SirDomsen/RC-LAP-TIMER-PRO/ROADMAP.md

# 🏁 RC LAP TIMER PRO – SYSTEM ROADMAP & ARCHITEKTUR

> **Interne System-Roadmap & Modulübersicht für AI-Assistenten und Entwickler.**  
> *Stand Firmware: v4.7.0 | Basisstation: ESP8266 oder ESP32-S3 + Sektorstationen: ESP-01S + Transponder: ATtiny13A*

---

## 🧭 1. Projektübersicht & Philosophie
**RC Lap Timer Pro** ist ein autarkes, hochpräzises Infrarot-Rundenzählersystem für RC-Cars (Maßstäbe 1:10, 1:8, 1:24 etc.). Die Basisstation läuft auf ESP8266 oder ESP32-S3; Bedienung und Live-Anzeige erfolgen über ein responsives Web-Frontend (HTML5 / Vanilla JS / WebSockets).

* **Basisstation (`LT_Base/`):** Gemeinsame Rennlogik und Web-App mit separaten ESP8266- und ESP32-S3-Hardwareadaptern; empfängt Start/Ziel-Transponder, betreibt Webserver/WebSockets und verwaltet Rekorde und Sessions.
* **Sektorstationen (`LT_SectorStation/`, SZ1–SZ3):** Eigenständiges ESP-01S-Projekt. Die Stationen erfassen Zwischenzeiten und übertragen sie synchronisiert per ESP-NOW an die Basis.
* **Transponder (`attiny13_tx/`):** ATtiny13-Sender in jedem RC-Car mit individuellen 12-Bit-IR-Codes auf 38 kHz.

---

## ⚙️ 2. PlatformIO Environments & Build-Konfiguration

Die Projekte besitzen getrennte PlatformIO-Konfigurationen. `LTCommon` liegt unter `LT_Base/lib/LTCommon/` und wird sowohl von der Basis als auch von den Sektorstationen eingebunden.

| Projekt / Environment | Board | Takt | Dateisystem | Zweck |
| :--- | :--- | :--- | :--- | :--- |
| `LT_Base` / `basisstation` | NodeMCU V2 (`nodemcuv2`) | 160 MHz | LittleFS | ESP8266-Basis, LWIP2 Low Memory |
| `LT_Base` / `basisstation_s3` | ESP32-S3 DevKitC-1 N16R8 | 240 MHz | LittleFS | ESP32-S3-Basis, 16 MB Flash, 8 MB Octal-PSRAM, USB-CDC |
| `LT_SectorStation` / `sz1` | ESP-01S (`esp01_1m`) | 160 MHz | - | Sektorstation 1 (`-DSECTOR_STATION -DSTATION_ID=1`) |
| `LT_SectorStation` / `sz2` | ESP-01S (`esp01_1m`) | 160 MHz | - | Sektorstation 2 (`-DSECTOR_STATION -DSTATION_ID=2`) |
| `LT_SectorStation` / `sz3` | ESP-01S (`esp01_1m`) | 160 MHz | - | Sektorstation 3 (`-DSECTOR_STATION -DSTATION_ID=3`) |

Builds werden vom Repository-Root aus z. B. mit `pio run -d LT_Base -e basisstation`, `pio run -d LT_Base -e basisstation_s3` oder `pio run -d LT_SectorStation -e sz1` gestartet. Das LittleFS-Image der Basis wird mit `pio run -d LT_Base -e basisstation -t buildfs` gebaut.

---

## 📡 3. Hardware- & Signal-Architektur

### 3.1 Transponder (`attiny13_tx/Attiny_tx.ino`)
* **Hardware:** ATtiny13A (9.6 MHz intern), IR-LED an PB3.
* **Signal:** 38 kHz Burst (Impulsbreiten-Codierung).
* **Frame-Struktur:** 12-Bit Micro-Frame (~16 ms Dauer).
  * Leader: 2000 µs Puls + 1000 µs Pause.
  * Daten: 6 Bit Car-ID (1–15, ID 0 = Startschranke) + 6 Bit invertierte Car-ID zur Fehlerprüfung.
  * Bit 0 = 350 µs Puls / 350 µs Pause (~700 µs).
  * Bit 1 = 350 µs Puls / 1050 µs Pause (~1400 µs).
* **Entzerrung:** LFSR Pseudo-Zufallspause von 15 bis 30 ms zwischen Sendungen (verhindert Signalüberlagerung bei Pulkfahrten).

### 3.2 IR-Decoder (`LT_Base/lib/LTCommon/src/ir_decoder.cpp`)
* **Hardware:** TSOP4838 an D2 (GPIO4 bei Basis) bzw. GPIO3/RX (ESP-01S bei SZ).
* **Empfang:** Interrupt auf fallende Flanke (`handleIRInterrupt()`).
* **Sicherheit:** Striktes Timing-Fenster für Header (1800–4200 µs) und Bits (400–1800 µs, Schwelle 950 µs). Bei jeder kleinsten Abweichung erfolgt ein sofortiger Hard-Reset des Schieberegisters.

### 3.3 ESP-NOW Funknetzwerk (`esp_now_base.cpp` & `LT_SectorStation/src/main.cpp`)
* **Sync-Master:** Basis sendet periodische Beacons (`BeaconSyncPacket`, Stratum 0).
* **Kanal-Verfolgung:** Sektorstationen hoppen durch die WLAN-Kanäle bis zum Beacon-Lock.
* **Multi-Hop / Stratum:** Stationen synchronisieren lokale Mikrosekunden mit ~1 ms Hop-Kompensation und leiten Pakete weiter (Relay Queue & Cache).
* **Heartbeat & Telemetrie:** Alive-Pakete melden Status und Batteriespannung (Teiler an A0).
* **Remote OTA-Trigger:** Basis kann SZs über ESP-NOW anweisen, in den Wartungsmodus zu wechseln und sich mit dem Heim-WLAN oder AP für Firmware-Updates zu verbinden.

---

## 💻 4. Backend-Architektur Basisstation (`LT_Base/src/common/`)

### 4.1 Zeit- & Rennlogik (`lap_logic.cpp`)
* **Rennmodi:**
  * `MODE_PRACTICE` (0): Freies Training, endlose Zeiterfassung, automatische Erkennung.
  * `MODE_QUALIFYING` (1): Zeitbasiertes Qualifying mit automatischer Restzeitansage.
  * `MODE_RACE_LAPS` (2): Rennen auf Rundenanzahl (Startampel / Countdown, Zieldurchfahrt).
  * `MODE_RACE_TIME` (3): Rennen auf Zeit (z. B. 5-Minuten-Lauf, letzte Runde zu Ende fahren).
  * `MODE_DRAGRACE` (4): Sprint-Messung (Start an Basis, Sektor-Messung bis Zielschranke).
* **Sektoren (SZ1–SZ4):** S1 bis S3 von Funk-Stationen, S4 = Zieldurchfahrt Basis. Berechnung von Einzel- und Splitzeiten, Personal Best (PB, Grün) und absoluter Bestzeit (Purple).
* **Filterung & Entprellung:**
  * 2-Frame-Filter (erfordert zwei identische Frames innerhalb von 85 ms).
  * Einstellbare Deadtime (`minLapTimeMs`, Standard 2000 ms).
  * Dynamische Boxen-/Pause-/Outlap-Erkennung bei langen Standzeiten.

### 4.2 Speicherverwaltung (`storage.cpp`)
* **Dateisystem LittleFS:**
  * `/tracks.json`: Streckenkatalog mit All-Time Top 5 und Tagesbestzeiten Top 5.
  * `/sessions.json`: Index aller gefahrenen Sessions.
  * `/<track>/<mode>/<YY-MM-DD_HH-MM-SS>.json`: Detaillierte Rundenprotokolle inklusive aller 4 Sektoren und Zeitstempel.
  * `/wifi.json` & `/names.json`: WLAN-Zugänge, Fahrer- und Fahrzeugnamen (bis zu 15 Fahrzeuge).
* **Pufferung & Schutz:**
  * `PendingLap lapQueue[30]`: Rundenzeiten werden im RAM gepuffert und asynchron weggeschrieben, um den Loop nicht zu blockieren.
  * **95%-Flash-Schutz (`storageFullLocked`):** Verhindert das Einfrieren des ESP8266 bei vollem Speicher.
  * Reset-Ursache und Details werden in einem größenbegrenzten `/crash.log` protokolliert; der Webserver stellt Crash-Log und Dateisystembelegung über leichtgewichtige Diagnose-Endpunkte bereit.

### 4.3 Arcade-Sound & Signal-Akustik (`buzzer.cpp` / `buzzer.h` / `Sound/`)
* **Hardware:** 32Ω Mylar- oder PC-Lautsprecher an **D1 (GPIO5)**, getrieben über **BC337-Transistor** (1kΩ Basiswiderstand) an 5V/VIN.
* **Architektur:** 100% non-blocking State-Machine im `loop()`, **0 Byte Heap-Allokation** (alle Tonfolgen in `PROGMEM` unter `LT_Base/Sound/`), dynamische Staccato-Artikulation für klassische MIDI- und `wav2c`-extrahierte Notenfolgen.
* **Sound-Events & Soundtracks:**
  * **Startampel:** Original Grand Prix Circuit (1988) Sequenz (2x Rot 260 Hz à 300 ms, 650 ms Pause ➔ Grün 1050 Hz à 450 ms), synchronisiert mit Renn-Countdown in `modes.js`.
  * **Zieldurchfahrt:** Kurzer, trockener Bestätigungs-Impuls (1760 Hz, 35 ms) direkt bei Zieldurchfahrt in `lap_logic.cpp`.
  * **Streckenrekord:** Aufsteigende 4-Ton Arcade-Fanfare bei neuem Streckenrekord / absoluter Bestzeit.
  * **Sieg über Geist / Geisterjagd:** Schnelle 6-Ton Sieges-Fanfare (G4-C5-E5-G5-E5-G5) bei Unterbietung der Geisterzeit.
  * **SZ-Durchfahrts-Ticks:** A7 Chiptune-Tick (3520 Hz) an Zwischenstationen SZ1–SZ3 als akustisches Lebenszeichen / Latenz-Rückmeldung (Fahrer 1 Einzeltick 25 ms, Fahrer 2 Doppeltick).
  * **Accolade Arcade Jukebox (8 Original MS-DOS Chiptunes):**
    * *Grand Prix Circuit (1988):* 🏎️ Title Theme (180 Noten, 32s) & 🏁 Menu Theme (448 Noten, 54s).
    * *Test Drive 1 (1987):* 🚗 Intro / Title Theme & ⚡ Menu Beat (authentischer Synth-Groove).
    * *Test Drive 3: The Passion (1990):* 🔥 Title Theme, 📻 Radio 1 (Synth-Rock), 📻 Radio 2 (Synth-Bass), 📻 Radio 3 (Melodic Groove).
* **Steuerung & UI-Integration:**
  * **Rennleiter Jukebox-Modal (`admin.html`):** Button `📼 Arcade Audio` öffnet dedizierten Player mit Soundtrack-Dropdown, Loop-Schalter, Play/Stop und Sound FX Tests.
  * **Countdown-Stummschaltung:** Einstellbar im Fahrer-Setup (`index.html`) und direkt im Arcade-Modal des Rennleiters (`admin.html`) für 100% synchronen Startampel-Buzzer ohne Sprach-Latenz.
  * **Web-API:** `/api/buzzer` (`cmd=play&track=<id>&loop=1|0`, `cmd=start|lap|record|title|menu|stop`, `enable=1|0`).
* **Ruhestrom-Schutz:** Pin wird im Standby fest auf `LOW` gehalten, sodass der Transistor komplett sperrt und kein Strom fließt.

### 4.4 Webserver & Netzwerk (`web_server.cpp` / `web_handlers.cpp`)
* **WLAN-Kaskade:** Heim-WLAN ➔ Mobiler Hotspot ➔ Eigener SoftAP (`RC-LapTimer-XXXX`, höchstens 4 WLAN-Clients; im AP-Modus höchstens 3 aktive Fahrer-WebSockets).
* **Gelernte IP:** Merkt sich die im Heimnetz vergebene IP und nutzt diese auch im SoftAP, damit Browser-Lesezeichen immer gültig bleiben.
* **Geister-WLAN (`setupGhostWLAN()`):** Nach dem Booten im Heimnetz wird kurzzeitig ein eigenes Hilfs-WLAN mit der IP im Namen aufgespannt (`LT_<SSID>-<IP>`), damit der Nutzer die IP sofort sieht. Schaltet nach dem ersten Webaufruf automatisch ab.
* **Dynamischer Heap-Schutz:** Der Datei-Guard passt seine ESP8266-Grenzen dem WLAN-Modus an (AP: 5.5 kB / 75 % Fragmentierung / 1.4 kB größter Block; Station: 7.5 kB / 70 % / 1.8 kB). `/api/laps` hat einen separaten 3.5-kB-Guard (ESP8266; 8 kB auf S3); WebSocket-Neuverbindungen werden bei knappem Heap oder belegten Fahrer-Slots mit Code 1013 abgewiesen. CSS/JS bleiben für den Recovery-Loader abrufbar.
* **4-Säulen Client-Lifecycle:** Verhindert TCP-PCB-Erschöpfung auf dem ESP8266 im AP-Modus:
  1. `tabId`-Zuordnung via `sessionStorage` (Reloads im selben Browser-Tab ersetzen alte Sockets gezielt).
  2. TCP-Sendestau-Erkennung (`queueLen() > 0` für $\ge 8\,\text{s}$) für gesperrte Handys im Standby.
  3. Der WebSocket-Gate lässt im AP-Modus maximal drei Fahrer zu und weist weitere Verbindungen zurück, statt bestehende Fahrer zu verdrängen. `ws.cleanupClients()` entfernt nur geschlossene Clients.
  4. Sauberes Teardown via `pagehide` / `beforeunload` ohne Reconnect-Stürme.
* **Grand Prix Circuit Startampel & Standby-Re-Sync:**
  * Visuelle Ampel-Heartbeat-Anzeige (Rot=Standby, Gelb=Sync, Grün=Live) auf Fahrer- und Admin-Seite sowie im OLED-Dimmer.
  * Automatischer Reconnect mit 500 ms WLAN-Stabilisierungspuffer beim Entsperren des Smartphones ohne manuelles Neuladen.

---

## 🖥️ 5. Frontend-Architektur (`LT_Base/data/`)

* **`index.html` (Fahrer-Dashboard):**
  * Bereinigtes Display für Teilnehmer und Zuschauer.
  * Integrierter **OLED-Dimmer-Modus**: Großschrift-Ansicht für Handys an der Strecke mit minimalem Akkuverbrauch.
* **`admin.html` (Rennleiter):**
  * Vollzugriff auf Session-Steuerung, Streckenwechsel, Fahrerumbenennung, Sensor-Live-Debug und Hardware-Konfiguration.
* **`main.js`:**
  * Zentraler Controller, WebSocket-Event-Verarbeitung (`lap`, `sector`, `outlap`, `drag_start`, `drag_finish`).
  * Live-Leaderboard-Rendering mit Delta-Zeiten zur Bestzeit.
* **`modes.js`:**
  * Start-Sequenzen (3-2-1-Los Sprachcountdown), Rennabbruch, Runden- und Zeit-Sessions.
* **`stats.js`:**
  * Multi-Tab-Statistiken (Fahrerprofile, Trainings, Quali, Rennen, Dragrace).
  * Strecken-Filterung, Session-Details mit Einzelrunden.
  * **Backup & Restore:** Vollständiger JSON-Export und Wiederherstellung aller Strecken- und Session-Daten.
* **`config.js`:**
  * Dialoge für WLAN-Umschaltung, Transponder-Deadtime, 2-Frame-Filter, Sektor-Audio, Cache-Steuerung und SZ-OTA.
* **`tts.js`:**
  * Web Speech API Sprachausgabe auf Deutsch (`de-DE`).
  * Sprach-Warteschlange mit Watchdog, gezielte Fahrer-Filterung ("Nur mein Auto ansagen"), iOS-Audio-Unlock.
* **`update.html`:**
  * LittleFS-Dateimanager (Ordner-Ansicht, ZIP-Download einzelner Ordner oder des gesamten Speichers) und Firmware-OTA-Upload.
* **`debug.html`:**
  * Live-Monitoring von ESP-Loop-Zeiten, Heap, ESP-NOW Funkpaketen und Signalstärken via Dual-Endpunkt (`/api/debug/system` & `/api/system/metrics`) mit dynamischer Farbkodierung (Neon-Cyan / Grün / Orange / Rot).
  * Integrierte **Frontend- & Asset-Live-Diagnose** (automatische Prüfung von HTTP-Status, GZIP-Kompression, JS-Syntax und WebSocket-Handshake für alle 4 Webseiten inklusive `update.html` und `debug.html`).
  * Integrierte **Audio & Buzzer Test-Konsole**: 3-teilige Prüfumgebung mit interaktiven Buttons für ESP8266 Hardware-Buzzer FX & 8-Track Jukebox, Smartphone Web Audio Synthesizer (100% klanggleich) und Web Speech API (TTS-Rennansagen).
* **`banner.jpg` / `banner.webp` & `style.css`:**
  * Original Synthwave/Arcade Hero-Banner (1024×434 px, 2,36:1 Breitwandformat) mit Zielflaggen-Muster und integriertem "RC LAP TIMER" Logo im `.hero-header`.
  * Perfekt proportionierte, unverzerrte Skalierung (`aspect-ratio: 1024 / 434`) ohne HTML-Textüberlagerung.
  * Schmale, zentrierte Rollen-Umschaltleiste (`.role-badge-bar`) direkt unter dem Banner vor den Funktions-Cards.

---

## 🗺️ 6. Funktions- & Modul-Matrix

```mermaid
flowchart TD
    subgraph Hardware
        TX[ATtiny13 TX Transponder 38kHz] -->|IR Signal| TSOP[TSOP4838 Sensor]
        SZ[ESP-01S Sektorstationen SZ1-SZ3] -->|ESP-NOW Funksignal| BASE[Gemeinsame Basisstations-Firmware]
        TSOP --> BASE
    end

    subgraph Firmware_Backend
        BASE --> TARGET[ESP8266- oder ESP32-S3-Adapter]
        BASE --> IR_DEC[IR Decoder ISR]
        BASE --> ESPNOW_RX[ESP-NOW Base Receiver]
        IR_DEC --> LAP_CORE[Lap Logic & Sektorberechnung]
        ESPNOW_RX --> LAP_CORE
        LAP_CORE --> STORAGE[Storage Manager LittleFS & EEPROM]
        LAP_CORE --> WS_SRV[Async WebServer & WebSockets]
    end

    subgraph Web_Frontend
        WS_SRV -->|WebSocket Live Events| CLIENT_WS[websocket.js]
        CLIENT_WS --> UI_MAIN[main.js / Live Table]
        CLIENT_WS --> UI_TTS[tts.js / Sprachausgabe]
        UI_MAIN --> UI_MODES[modes.js / Rennabläufe]
        STORAGE -->|REST API / JSON| UI_STATS[stats.js / Runden & Rekorde]
        STORAGE -->|REST API / JSON| UI_CFG[config.js / Einstellungen]
    end
```

---

## 📋 7. Unverzichtbare Entwicklungsregeln für Antigravity

1. **Zuerst reden, dann coden:** Jede Codeänderung oder Feature-Erweiterung wird zuerst diskutiert und konzipiert. Erst nach Bestätigung des Users wird editiert.
2. **Projektstruktur:** Basisstationsquellen und Webassets gehören nach `LT_Base/`; Sektorstationsquellen nach `LT_SectorStation/`; die Transponder-Referenz bleibt unter `attiny13_tx/`. Gemeinsame Decoder- und Protokollteile liegen in `LT_Base/lib/LTCommon/`.
3. **Cache-Busting-Pflicht:** Sobald `LT_Base/data/*.js` oder `LT_Base/data/*.css` geändert werden, **muss** die Versionsnummer in `admin.html`, `index.html` und `LT_Base/src/common/config.h` (`FIRMWARE_VERSION`) synchron erhöht werden (`?v=X.X.X`).
4. **RAM-Schonung auf dem ESP8266:** Nie blockierende Loops oder große Strings auf dem Heap erzeugen. JSON-Dokumente strikt mit ArduinoJson 7 reservieren oder direkt streamen.
5. **Code-Integrität:** Bestehende Sicherheitsmechanismen (Heap-Guard, 95%-Flash-Schutz, Sektor-Entprellung, ISR-Zeitschranken) niemals aus Versehen entfernen oder abschwächen; Änderungen am gemeinsamen Basisstationskern müssen für ESP8266 und ESP32-S3 gebaut werden.
