SirDomsen/RC-LAP-TIMER-PRO/SChaltplanASCII.docx

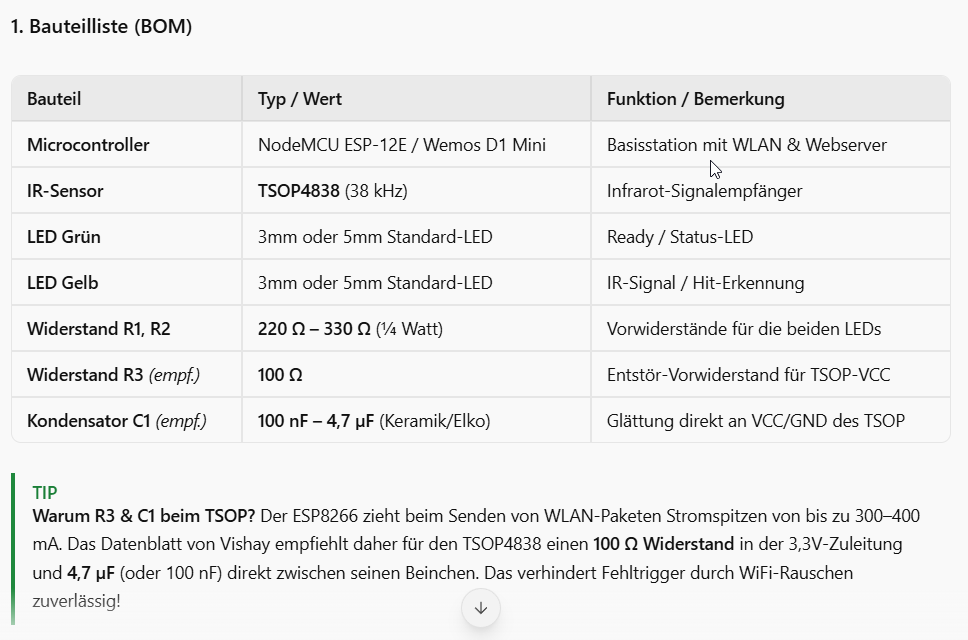
[picture p1: figure]
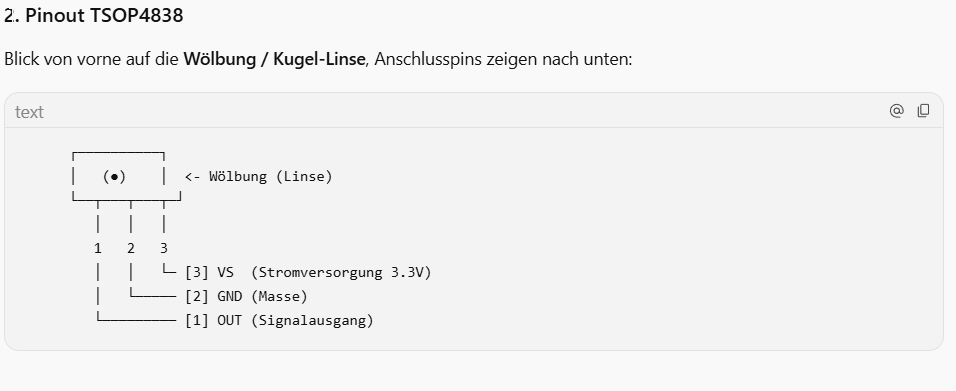
[picture p2: figure]
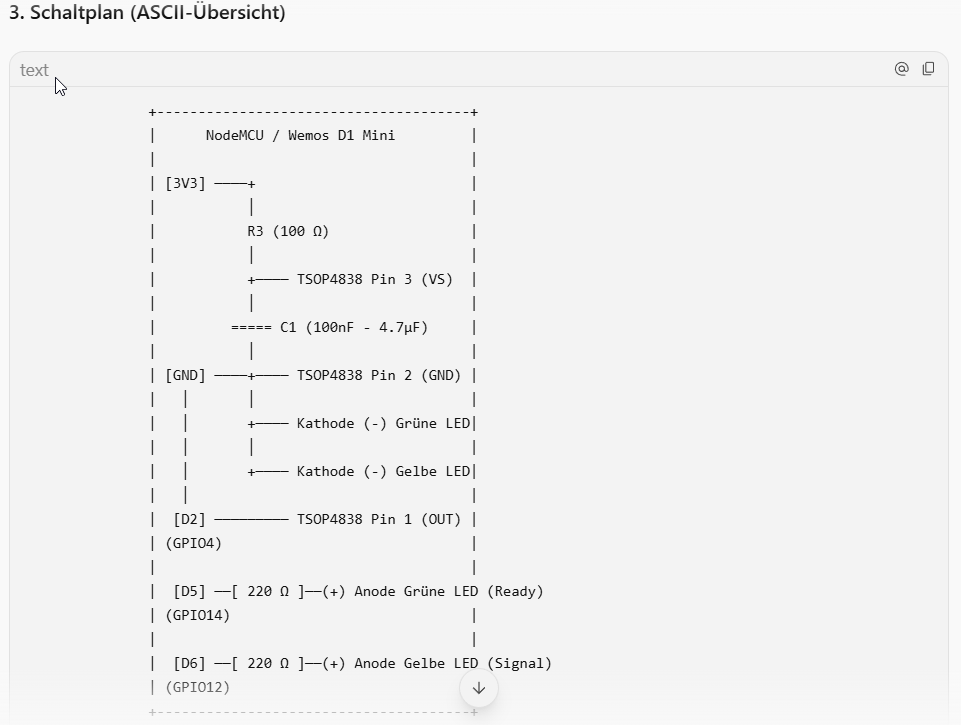
[picture p3: figure]
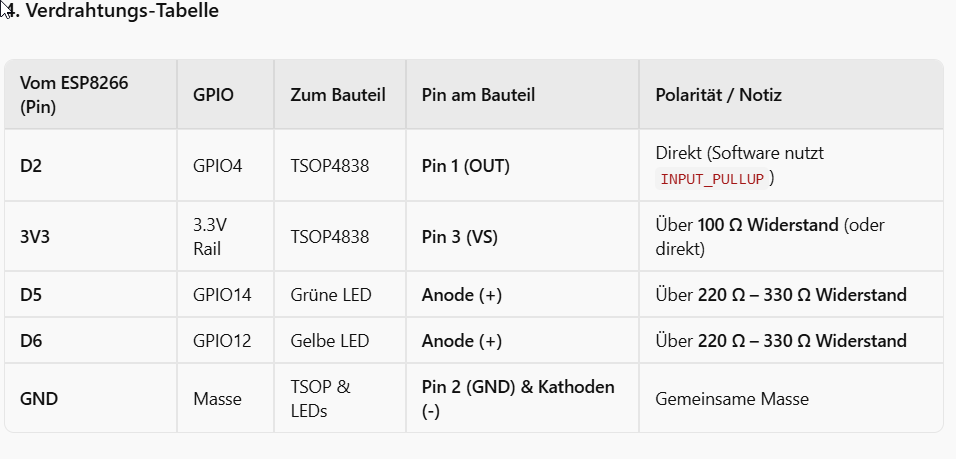
[picture p4: figure]
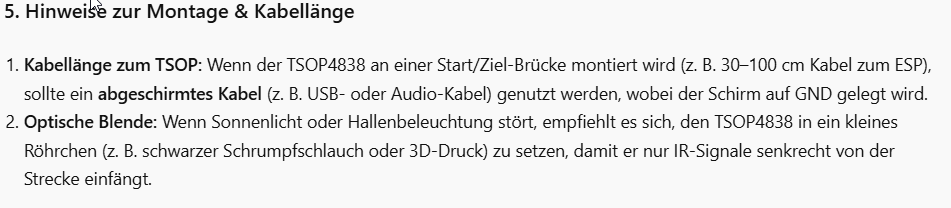
[picture p5: figure]
