SirDomsen/RC-LAP-TIMER-PRO/esp8266_rx/src/lap_logic.cpp

#include "lap_logic.h"
#include <lap_ir_input.h>
#include <race_rules.h>
#include "storage.h"
#include "web_server.h"
#include "buzzer.h"
#include <status_leds.h>
#include <sys/time.h>
#include <LittleFS.h>
#include <ArduinoJson.h>

uint32_t lastCrossTime[MAX_CARS + 1]   = {0};
uint32_t lastLapDuration[MAX_CARS + 1] = {0};
uint32_t bestLapDuration[MAX_CARS + 1] = {0};
uint16_t lapCounter[MAX_CARS + 1]      = {0};
uint16_t targetRounds                  = 0;
uint16_t minLapTimeMs                  = DEFAULT_MIN_LAP_MS;

bool useSz1 = true;
bool useSz2 = true;
bool useSz3 = true;
bool checkpointMode = false;
bool dragraceMode = false;
bool sectorAudioFeedback = true;

bool awaitingBaseCross[MAX_CARS + 1] = {true, true, true, true, true, true, true, true, true, true, true, true, true, true, true, true};
bool finishedFinalLap[MAX_CARS + 1]  = {false};
bool dragRunActive[MAX_CARS + 1]     = {false};
bool dragTrackOccupied               = false;
uint8_t activeDragCarId              = 0;

bool inPitOrPause[MAX_CARS + 1]      = {false};
uint32_t pitEnteredMs[MAX_CARS + 1]  = {0};
bool isOutLap[MAX_CARS + 1]          = {false};
bool lastLapIsOutLap[MAX_CARS + 1]   = {false};

// Ringpuffer für die letzten 3 gültigen Rundenzeiten pro Fahrzeug
static uint32_t recentValidLaps[MAX_CARS + 1][3] = {{0}};
static uint8_t  recentValidLapCount[MAX_CARS + 1] = {0};
static uint8_t  recentValidLapIdx[MAX_CARS + 1]   = {0};

// Bitmaske zum Schutz vor doppelter Sektorerfassung in derselben Runde (Bit 1=SZ1, Bit 2=SZ2, Bit 3=SZ3)
static uint8_t sectorPassedInLap[MAX_CARS + 1] = {0};

// Sektorzeiten
uint32_t sz1TimeMs[MAX_CARS + 1] = {0};
uint32_t sz2TimeMs[MAX_CARS + 1] = {0};
uint32_t sz3TimeMs[MAX_CARS + 1] = {0};
uint32_t sz4TimeMs[MAX_CARS + 1] = {0};

// Split-Zeiten
uint32_t split1TimeMs[MAX_CARS + 1] = {0};
uint32_t split2TimeMs[MAX_CARS + 1] = {0};
uint32_t split3TimeMs[MAX_CARS + 1] = {0};

uint32_t bestSz1TimeMs[MAX_CARS + 1] = {0};
uint32_t bestSz2TimeMs[MAX_CARS + 1] = {0};
uint32_t bestSz3TimeMs[MAX_CARS + 1] = {0};
uint32_t bestSz4TimeMs[MAX_CARS + 1] = {0};

uint32_t overallBestSz1Ms = 0;
uint32_t overallBestSz2Ms = 0;
uint32_t overallBestSz3Ms = 0;
uint32_t overallBestSz4Ms = 0;

uint32_t lastSectorTimeMs[MAX_CARS + 1] = {0};

static uint8_t currentExpectedSector[MAX_CARS + 1] = {0};

RaceMode currentMode = MODE_PRACTICE;
uint32_t modeEndTimeMs = 0;
uint16_t durationMinutes = 0;

uint8_t recentIDs[5] = {0, 0, 0, 0, 0};

uint32_t lastSeenMs[MAX_CARS + 1] = {0};
bool readyForNextLap[MAX_CARS + 1] = {false};

uint64_t baseUnixTimestampSec = 0;
uint32_t baseMillis = 0;

// All-Time Streckenrekord (P1 der aktiven Strecke)
uint32_t allTimeBestLapMs = 0;
uint8_t allTimeBestCarId = 0;
String allTimeBestDriver = "";
String allTimeBestCar = "";
String allTimeBestDate = "";
uint32_t allTimeBestS1Ms = 0;
uint32_t allTimeBestS2Ms = 0;
uint32_t allTimeBestS3Ms = 0;
uint32_t allTimeBestS4Ms = 0;
uint8_t allTimeBestSzMask = 0;

// Tagesbestzeit-Variablen (P1 heute der aktiven Strecke)
uint32_t dailyBestLapMs = 0;
uint8_t dailyBestCarId = 0;
String dailyBestDriver = "";
String dailyBestCar = "";
String dailyBestDate = "";
uint32_t dailyBestS1Ms = 0;
uint32_t dailyBestS2Ms = 0;
uint32_t dailyBestS3Ms = 0;
uint32_t dailyBestS4Ms = 0;
uint8_t dailyBestSzMask = 0;

// Geisterjagd (Modus 5)
uint8_t ghostTargetType = 0;
uint8_t ghostCarId = 0;
uint32_t ghostLapMs = 0;
uint32_t ghostS1Ms = 0;
uint32_t ghostS2Ms = 0;
uint32_t ghostS3Ms = 0;
uint32_t ghostS4Ms = 0;
uint32_t ghostSplit1Ms = 0;
uint32_t ghostSplit2Ms = 0;
uint32_t ghostSplit3Ms = 0;
uint8_t ghostSzMask = 0;
String ghostDriverName = "";
String ghostCarName = "";
bool ghostAudioEnabled = true;

const uint16_t CLEARANCE_TIMEOUT_MS = 1000; 

void loadDailyBest() {
  loadTracksFromFS();
}

void saveDailyBest() {
  saveActiveTrackBestToFS();
}

uint32_t getAverageLapTimeMs(uint8_t carId) {
  if (carId < 1 || carId > MAX_CARS || recentValidLapCount[carId] == 0) return 0;
  uint32_t sum = 0;
  for (uint8_t i = 0; i < recentValidLapCount[carId]; i++) {
    sum += recentValidLaps[carId][i];
  }
  return sum / recentValidLapCount[carId];
}

static void addValidLapToAverage(uint8_t carId, uint32_t lapTimeMs) {
  if (carId < 1 || carId > MAX_CARS || lapTimeMs == 0) return;
  recentValidLaps[carId][recentValidLapIdx[carId]] = lapTimeMs;
  recentValidLapIdx[carId] = (recentValidLapIdx[carId] + 1) % 3;
  if (recentValidLapCount[carId] < 3) {
    recentValidLapCount[carId]++;
  }
}

void setGhostTarget(uint8_t targetType, uint32_t lapMs, uint32_t s1, uint32_t s2, uint32_t s3, uint32_t s4, uint8_t szMask, const String& driver, const String& car, uint8_t carId) {
  ghostTargetType = targetType;
  ghostCarId = carId;
  ghostLapMs = lapMs;
  ghostS1Ms = s1;
  ghostS2Ms = s2;
  ghostS3Ms = s3;
  ghostS4Ms = s4;
  ghostSzMask = szMask;
  ghostDriverName = driver.length() > 0 ? driver : "Geist";
  ghostCarName = car.length() > 0 ? car : "";

  ghostSplit1Ms = (s1 > 0) ? s1 : 0;
  ghostSplit2Ms = (s2 > 0) ? (ghostSplit1Ms + s2) : 0;
  ghostSplit3Ms = (s3 > 0) ? (ghostSplit2Ms + s3) : 0;

  char ghostBuf[256];
  snprintf(ghostBuf, sizeof(ghostBuf),
    "{\"type\":\"ghost_target\",\"targetType\":%d,\"lap\":%lu,\"s1\":%lu,\"s2\":%lu,\"s3\":%lu,\"s4\":%lu,\"szMask\":%d,\"driver\":\"%s\",\"car\":\"%s\"}",
    ghostTargetType, (unsigned long)ghostLapMs, (unsigned long)ghostS1Ms, (unsigned long)ghostS2Ms, (unsigned long)ghostS3Ms, (unsigned long)ghostS4Ms,
    ghostSzMask, ghostDriverName.c_str(), ghostCarName.c_str());
  broadcastWebSocket(ghostBuf);
}

void broadcastSectorEvent(uint8_t carId, uint8_t sectorNum, uint32_t sectorTimeMs, uint32_t splitTimeMs, bool isPB, bool isOverallBest, int32_t deltaMs, bool isFinalSector = false) {
  int32_t ghostDeltaMs = 0;
  bool hasGhostDelta = false;

  if (currentMode == MODE_GHOST_HUNT) {
    uint32_t refGhostSplit = 0;
    if (sectorNum == 1) refGhostSplit = ghostSplit1Ms;
    else if (sectorNum == 2) refGhostSplit = ghostSplit2Ms;
    else if (sectorNum == 3) refGhostSplit = ghostSplit3Ms;

    if (refGhostSplit > 0) {
      ghostDeltaMs = (int32_t)splitTimeMs - (int32_t)refGhostSplit;
      hasGhostDelta = true;
      if (ghostAudioEnabled && !isFinalSector) {
        if (getActiveCarsCount(300000UL) <= 1) {
          if (ghostDeltaMs <= 0) playBuzzerGhostAhead();
          else playBuzzerGhostBehind();
        }
      }
    }
  }

  char buffer[256];
  if (hasGhostDelta) {
    snprintf(buffer, sizeof(buffer), 
      "{\"type\":\"sector\",\"carId\":%d,\"driver\":\"%s\",\"sector\":%d,\"time\":%lu,\"split\":%lu,\"isPB\":%s,\"isOverallBest\":%s,\"delta\":%ld,\"ghostDelta\":%ld,\"isFinal\":%s}",
      carId, driverNames[carId].c_str(), sectorNum, (unsigned long)sectorTimeMs, (unsigned long)splitTimeMs,
      isPB ? "true" : "false", isOverallBest ? "true" : "false", (long)deltaMs, (long)ghostDeltaMs, isFinalSector ? "true" : "false");
    broadcastWebSocket(buffer);
    return;
  }

  snprintf(buffer, sizeof(buffer), 
    "{\"type\":\"sector\",\"carId\":%d,\"driver\":\"%s\",\"sector\":%d,\"time\":%lu,\"split\":%lu,\"isPB\":%s,\"isOverallBest\":%s,\"delta\":%ld,\"isFinal\":%s}",
    carId, driverNames[carId].c_str(), sectorNum, (unsigned long)sectorTimeMs, (unsigned long)splitTimeMs,
    isPB ? "true" : "false", isOverallBest ? "true" : "false", (long)deltaMs, isFinalSector ? "true" : "false");
  broadcastWebSocket(buffer);
}

void broadcastLapEvent(uint8_t carId, uint16_t lapNum, uint32_t lapTimeMs, uint8_t pos, bool isPB, bool isOverallBest, bool isTrackRecord, bool isDailyRecord, bool isOutLap) {
  char buffer[256];
  snprintf(buffer, sizeof(buffer), 
    "{\"type\":\"lap\",\"carId\":%d,\"driver\":\"%s\",\"lap\":%d,\"lapTime\":%lu,\"pos\":%d,\"isPB\":%s,\"isOverallBest\":%s,\"isTrackRecord\":%s,\"isDailyRecord\":%s,\"isOutLap\":%s}",
    carId, driverNames[carId].c_str(), lapNum, (unsigned long)lapTimeMs, pos, 
    isPB ? "true" : "false", isOverallBest ? "true" : "false",
    isTrackRecord ? "true" : "false", isDailyRecord ? "true" : "false",
    isOutLap ? "true" : "false");
  broadcastWebSocket(buffer);
}

void initLapLogic() {
  LapStatusLeds::init();
  
  currentMode = MODE_PRACTICE;
  modeEndTimeMs = 0;
  targetRounds = 0;
  
  loadDailyBest();
  resetAllLaps(false);
}

void syncClockOnce(uint64_t clientTsSec) {
  if (baseUnixTimestampSec == 0 || clientTsSec > baseUnixTimestampSec + 3600) {
    baseUnixTimestampSec = clientTsSec;
    baseMillis = millis();
    
    timeval tv = { (time_t)clientTsSec, 0 };
    settimeofday(&tv, nullptr);
    checkDailyBestDateRollover();
  }
  if (baseUnixTimestampSec > 0 && !ensureNameHistoryBaseline()) {
    Serial.println("[Names] Historischer Namens-Baseline konnte nicht vervollständigt werden.");
  }
}

uint64_t getCurrentTimestampMs() {
  if (baseUnixTimestampSec == 0) {
    return (uint64_t)millis();
  }
  uint32_t elapsedMs = millis() - baseMillis;
  return (baseUnixTimestampSec * 1000ULL) + elapsedMs;
}

void addRecentID(uint8_t newId) {
  for (int i = 4; i > 0; i--) {
    recentIDs[i] = recentIDs[i - 1];
  }
  recentIDs[0] = newId;
}

void resetAllLaps(bool isHardReset) {
  startNewSessionFrame((uint8_t)currentMode);

  for (uint8_t i = 0; i <= MAX_CARS; i++) {
    lastCrossTime[i] = 0;
    lastLapDuration[i] = 0;
    bestLapDuration[i] = 0;
    lapCounter[i] = 0;
    lastSeenMs[i] = 0;
    readyForNextLap[i] = true;
    awaitingBaseCross[i] = true;
    finishedFinalLap[i] = false;
    dragRunActive[i] = false;
    inPitOrPause[i] = false;
    pitEnteredMs[i] = 0;
    isOutLap[i] = false;
    lastLapIsOutLap[i] = false;
    sectorPassedInLap[i] = 0;
    currentExpectedSector[i] = 1;
    sz1TimeMs[i] = 0;
    sz2TimeMs[i] = 0;
    sz3TimeMs[i] = 0;
    sz4TimeMs[i] = 0;
    split1TimeMs[i] = 0;
    split2TimeMs[i] = 0;
    split3TimeMs[i] = 0;
    bestSz1TimeMs[i] = 0;
    bestSz2TimeMs[i] = 0;
    bestSz3TimeMs[i] = 0;
    bestSz4TimeMs[i] = 0;
    lastSectorTimeMs[i] = 0;
    recentValidLapCount[i] = 0;
    recentValidLapIdx[i] = 0;
    for (uint8_t j = 0; j < 3; j++) recentValidLaps[i][j] = 0;
  }
  dragTrackOccupied = false;
  activeDragCarId = 0;

  overallBestSz1Ms = 0;
  overallBestSz2Ms = 0;
  overallBestSz3Ms = 0;
  overallBestSz4Ms = 0;
  
  if (isHardReset) {
    // Setzt die Tagesbestzeiten (Top 5 heute) zurück, erhält aber den ewigen Streckenrekord!
    deleteTrackRecordEntry(activeTrackId, true, -1);
  }

  for (int i = 0; i < 5; i++) recentIDs[i] = 0;
  LapIrInput::resetFrameFilter();
  LapStatusLeds::cancelReadyPulse();
  broadcastWebSocket("{\"type\":\"reset\"}");
}

uint8_t getCurrentPosition(uint8_t carId) {
  return RaceRules::getPosition(
      carId, MAX_CARS, RaceRules::ranksByBestLap(currentMode),
      bestLapDuration, lapCounter, lastCrossTime);
}

bool areAllActiveCarsFinished() {
  if (!RaceRules::isTimedMode(currentMode)) return false;
  if (modeEndTimeMs == 0 || millis() <= modeEndTimeMs) return false;

  for (uint8_t i = 1; i <= MAX_CARS; i++) {
    if (RaceRules::isTimedEventCarPendingFinish(
            modeEndTimeMs, millis(), lapCounter[i], lastCrossTime[i] / 1000UL,
            lastSeenMs[i], finishedFinalLap[i], inPitOrPause[i], 60000UL)) {
      return false;
    }
  }
  return true;
}

uint8_t getActiveCarsCount(uint32_t timeoutMs) {
  uint32_t now = millis();
  uint8_t count = 0;
  for (uint8_t i = 1; i <= MAX_CARS; i++) {
    if (lastSeenMs[i] == 0) continue;

    if (inPitOrPause[i]) {
      // Auto ist im Status PIT: 300s Boxen-Timer laeuft ab
      if (pitEnteredMs[i] > 0 && (now - pitEnteredMs[i] < timeoutMs)) {
        count++; // Noch innerhalb der 300s Boxenpause -> zaehlt noch als aktiv
      }
      // Nach 300s ohne Zwischenzeit/Start-Ziel Durchfahrt -> inaktiv
    } else {
      // Auto faehrt auf der Strecke (nicht in der Box)
      if (now - lastSeenMs[i] < timeoutMs) {
        count++;
      }
    }
  }
  return count;
}

void processSectorPacket(uint8_t stationId, uint8_t carId, uint32_t timestampMs) {
  if (carId < 1 || carId > MAX_CARS) return;
  uint32_t now = millis();
  lastSeenMs[carId] = now;
  addRecentID(carId);

  if (currentMode == MODE_DRAGRACE) {
    if (!dragRunActive[carId] || lastCrossTime[carId] == 0) return;
  }

  if (RaceRules::isTimedMode(currentMode) && finishedFinalLap[carId]) {
    return;
  }

  if (timestampMs == 0 || (timestampMs > now && timestampMs - now > 5000) || (now > timestampMs && now - timestampMs > 300000)) {
    timestampMs = now;
  }

  if (currentMode != MODE_DRAGRACE && inPitOrPause[carId]) {
    lastLapIsOutLap[carId] = false;
    inPitOrPause[carId] = false;
    pitEnteredMs[carId] = 0;
    isOutLap[carId] = true;
    readyForNextLap[carId] = true;
    char outlapJson[96];
    snprintf(outlapJson, sizeof(outlapJson), "{\"type\":\"outlap\",\"carId\":%d,\"station\":%d}", carId, stationId);
    broadcastWebSocket(outlapJson);
  }

  if (currentMode != MODE_DRAGRACE && (lastCrossTime[carId] == 0 || lapCounter[carId] == 0)) {
    readyForNextLap[carId] = true;
    if (awaitingBaseCross[carId]) {
      awaitingBaseCross[carId] = false;
      isOutLap[carId] = true;
      char trackJson[64];
      snprintf(trackJson, sizeof(trackJson), "{\"type\":\"track_seen\",\"carId\":%d,\"station\":%d}", carId, stationId);
      broadcastWebSocket(trackJson);
    }
    return;
  }

  uint32_t lapStartMs = lastCrossTime[carId] / 1000UL;
  if (timestampMs < lapStartMs) {
    if (lapStartMs - timestampMs < 150) timestampMs = lapStartMs + 1;
    else return;
  }

  uint32_t elapsedMs = timestampMs - lapStartMs;
  if (!RaceRules::isValidIntermediateSectorDuration(elapsedMs)) return;

  uint32_t avgLap = getAverageLapTimeMs(carId);
  if (currentMode != MODE_DRAGRACE &&
      RaceRules::exceedsOutLapThreshold(avgLap, elapsedMs, PIT_PAUSE_FACTOR_PERCENT)) {
    isOutLap[carId] = true;
  }
  bool isOutSector = isOutLap[carId];

  // --- DRAGRACE LOGIK ---
  if (currentMode == MODE_DRAGRACE) {
    uint8_t targetSector = RaceRules::getActiveTargetSector(useSz1, useSz2, useSz3);
    if (targetSector == 0) return;

    if (stationId == targetSector) {
      if (sectorPassedInLap[carId] & (1 << targetSector)) return;
      sectorPassedInLap[carId] |= (1 << targetSector);

      dragRunActive[carId] = false;
      dragTrackOccupied = false;
      activeDragCarId = 0;
      readyForNextLap[carId] = false;

      if (targetSector == 3) {
        split3TimeMs[carId] = elapsedMs;
        uint32_t prevSplit = (useSz2 && split2TimeMs[carId] > 0) ? split2TimeMs[carId] : ((useSz1 && split1TimeMs[carId] > 0) ? split1TimeMs[carId] : 0);
        sz3TimeMs[carId] = (elapsedMs > prevSplit) ? (elapsedMs - prevSplit) : elapsedMs;
      } else if (targetSector == 2) {
        split2TimeMs[carId] = elapsedMs;
        uint32_t prevSplit = (useSz1 && split1TimeMs[carId] > 0) ? split1TimeMs[carId] : 0;
        sz2TimeMs[carId] = (elapsedMs > prevSplit) ? (elapsedMs - prevSplit) : elapsedMs;
      } else if (targetSector == 1) {
        split1TimeMs[carId] = elapsedMs;
        sz1TimeMs[carId] = elapsedMs;
      }

      uint32_t finishSecTime = (targetSector == 3) ? sz3TimeMs[carId] : ((targetSector == 2) ? sz2TimeMs[carId] : sz1TimeMs[carId]);
      bool isSecPB = false;
      bool isSecOverall = false;
      int32_t secDeltaMs = 0;

      if (targetSector == 3) {
        if (bestSz3TimeMs[carId] == 0 || finishSecTime < bestSz3TimeMs[carId]) {
          if (bestSz3TimeMs[carId] > 0) secDeltaMs = (int32_t)finishSecTime - (int32_t)bestSz3TimeMs[carId];
          bestSz3TimeMs[carId] = finishSecTime;
          isSecPB = true;
        } else {
          secDeltaMs = (int32_t)finishSecTime - (int32_t)bestSz3TimeMs[carId];
        }
        if (overallBestSz3Ms == 0 || finishSecTime < overallBestSz3Ms) {
          overallBestSz3Ms = finishSecTime;
          isSecOverall = true;
        }
      } else if (targetSector == 2) {
        if (bestSz2TimeMs[carId] == 0 || finishSecTime < bestSz2TimeMs[carId]) {
          if (bestSz2TimeMs[carId] > 0) secDeltaMs = (int32_t)finishSecTime - (int32_t)bestSz2TimeMs[carId];
          bestSz2TimeMs[carId] = finishSecTime;
          isSecPB = true;
        } else {
          secDeltaMs = (int32_t)finishSecTime - (int32_t)bestSz2TimeMs[carId];
        }
        if (overallBestSz2Ms == 0 || finishSecTime < overallBestSz2Ms) {
          overallBestSz2Ms = finishSecTime;
          isSecOverall = true;
        }
      } else if (targetSector == 1) {
        if (bestSz1TimeMs[carId] == 0 || finishSecTime < bestSz1TimeMs[carId]) {
          if (bestSz1TimeMs[carId] > 0) secDeltaMs = (int32_t)finishSecTime - (int32_t)bestSz1TimeMs[carId];
          bestSz1TimeMs[carId] = finishSecTime;
          isSecPB = true;
        } else {
          secDeltaMs = (int32_t)finishSecTime - (int32_t)bestSz1TimeMs[carId];
        }
        if (overallBestSz1Ms == 0 || finishSecTime < overallBestSz1Ms) {
          overallBestSz1Ms = finishSecTime;
          isSecOverall = true;
        }
      }

      lastLapDuration[carId] = elapsedMs;
      bool isPB = false;
      bool isOverall = false;

      if (bestLapDuration[carId] == 0 || elapsedMs < bestLapDuration[carId]) {
        bestLapDuration[carId] = elapsedMs;
        isPB = true;
      }

      uint32_t currentOverall = 0;
      for (uint8_t c = 1; c <= MAX_CARS; c++) {
        if (c != carId && bestLapDuration[c] > 0 && (currentOverall == 0 || bestLapDuration[c] < currentOverall)) {
          currentOverall = bestLapDuration[c];
        }
      }
      if (currentOverall == 0 || elapsedMs < currentOverall) {
        isOverall = true;
      }

      uint16_t completedRun = lapCounter[carId];
      lapCounter[carId]++;

      uint64_t currentTsMs = getCurrentTimestampMs();
      uint8_t pos = getCurrentPosition(carId);

      queueLapForStorage(carId, completedRun, elapsedMs, sz1TimeMs[carId], sz2TimeMs[carId], sz3TimeMs[carId], 0, pos, (uint8_t)currentMode, currentTsMs);

      LapStatusLeds::pulseReady();

      broadcastSectorEvent(carId, targetSector, finishSecTime, elapsedMs, isSecPB, isSecOverall, secDeltaMs);

      char finishJson[192];
      snprintf(finishJson, sizeof(finishJson),
        "{\"type\":\"drag_finish\",\"carId\":%d,\"driver\":\"%s\",\"time\":%lu,\"isPB\":%s,\"isOverallBest\":%s}",
        carId, driverNames[carId].c_str(), (unsigned long)elapsedMs, isPB ? "true" : "false", isOverall ? "true" : "false");
      broadcastWebSocket(finishJson);

      broadcastLapEvent(carId, completedRun, elapsedMs, 1, isPB, isOverall, false, false, false);
      if (isOverall) playBuzzerRecord(); else playBuzzerLap();
      return;
    }

    if (stationId < targetSector) {
      if (stationId == 1 && useSz1) {
        if (sectorPassedInLap[carId] & (1 << 1)) return;
        sectorPassedInLap[carId] |= (1 << 1);

        uint32_t s1 = elapsedMs;
        split1TimeMs[carId] = s1;
        sz1TimeMs[carId] = s1;
        lastSectorTimeMs[carId] = timestampMs;

        bool isPB = false;
        bool isOverall = false;
        int32_t deltaMs = 0;
        
        if (bestSz1TimeMs[carId] > 0) {
          deltaMs = (int32_t)s1 - (int32_t)bestSz1TimeMs[carId];
          if (s1 < bestSz1TimeMs[carId]) { bestSz1TimeMs[carId] = s1; isPB = true; }
        } else {
          bestSz1TimeMs[carId] = s1;
          isPB = true;
        }

        if (overallBestSz1Ms == 0 || s1 < overallBestSz1Ms) {
          overallBestSz1Ms = s1;
          isOverall = true;
        }
        broadcastSectorEvent(carId, 1, s1, s1, isPB, isOverall, deltaMs);
      } 
      else if (stationId == 2 && useSz2) {
        if (sectorPassedInLap[carId] & (1 << 2)) return;
        sectorPassedInLap[carId] |= (1 << 2);

        uint32_t split2 = elapsedMs;
        uint32_t prevSplit = (useSz1 && split1TimeMs[carId] > 0) ? split1TimeMs[carId] : 0;
        uint32_t s2 = (split2 > prevSplit) ? (split2 - prevSplit) : split2;

        split2TimeMs[carId] = split2;
        sz2TimeMs[carId] = s2;
        lastSectorTimeMs[carId] = timestampMs;

        bool isPB = false;
        bool isOverall = false;
        int32_t deltaMs = 0;

        if (bestSz2TimeMs[carId] > 0) {
          deltaMs = (int32_t)s2 - (int32_t)bestSz2TimeMs[carId];
          if (s2 < bestSz2TimeMs[carId]) { bestSz2TimeMs[carId] = s2; isPB = true; }
        } else {
          bestSz2TimeMs[carId] = s2;
          isPB = true;
        }

        if (overallBestSz2Ms == 0 || s2 < overallBestSz2Ms) {
          overallBestSz2Ms = s2;
          isOverall = true;
        }
        broadcastSectorEvent(carId, 2, s2, split2, isPB, isOverall, deltaMs);
      }
    }
    return;
  }

  // --- NORMALE RUNDENRENNEN-LOGIK ---
  if (stationId == 1 && useSz1) {
    if (checkpointMode &&
        currentExpectedSector[carId] != RaceRules::getExpectedSectorForStation(
            stationId, useSz1, useSz2, useSz3)) return;
    if (sectorPassedInLap[carId] & (1 << 1)) return;
    sectorPassedInLap[carId] |= (1 << 1);

    uint32_t split1 = elapsedMs;
    split1TimeMs[carId] = split1;
    sz1TimeMs[carId] = split1;
    lastSectorTimeMs[carId] = timestampMs;
    if (checkpointMode) currentExpectedSector[carId] = RaceRules::getNextExpectedSector(stationId);

    bool isPB = false;
    bool isOverall = false;
    int32_t deltaMs = 0;

    if (!isOutSector) {
      if (bestSz1TimeMs[carId] > 0) {
        deltaMs = (int32_t)split1 - (int32_t)bestSz1TimeMs[carId];
        if (split1 < bestSz1TimeMs[carId]) { bestSz1TimeMs[carId] = split1; isPB = true; }
      } else {
        bestSz1TimeMs[carId] = split1;
        isPB = true;
      }

      if (overallBestSz1Ms == 0 || split1 < overallBestSz1Ms) {
        overallBestSz1Ms = split1;
        isOverall = true;
      }
    }
    broadcastSectorEvent(carId, 1, split1, split1, isPB, isOverall, deltaMs);
  } 
  else if (stationId == 2 && useSz2) {
    if (checkpointMode) {
      uint8_t expected = RaceRules::getExpectedSectorForStation(
          stationId, useSz1, useSz2, useSz3);
      if (currentExpectedSector[carId] != expected) return;
    }
    if (sectorPassedInLap[carId] & (1 << 2)) return;
    sectorPassedInLap[carId] |= (1 << 2);

    uint32_t split2 = elapsedMs;
    uint32_t prevSplit = (useSz1 && (sectorPassedInLap[carId] & (1 << 1)) && split1TimeMs[carId] > 0) ? split1TimeMs[carId] : 0;
    uint32_t s2 = (split2 > prevSplit) ? (split2 - prevSplit) : split2;

    split2TimeMs[carId] = split2;
    sz2TimeMs[carId] = s2;
    lastSectorTimeMs[carId] = timestampMs;
    if (checkpointMode) currentExpectedSector[carId] = RaceRules::getNextExpectedSector(stationId);

    bool isPB = false;
    bool isOverall = false;
    int32_t deltaMs = 0;

    if (!isOutSector) {
      if (bestSz2TimeMs[carId] > 0) {
        deltaMs = (int32_t)s2 - (int32_t)bestSz2TimeMs[carId];
        if (s2 < bestSz2TimeMs[carId]) { bestSz2TimeMs[carId] = s2; isPB = true; }
      } else {
        bestSz2TimeMs[carId] = s2;
        isPB = true;
      }

      if (overallBestSz2Ms == 0 || s2 < overallBestSz2Ms) {
        overallBestSz2Ms = s2;
        isOverall = true;
      }
    }
    broadcastSectorEvent(carId, 2, s2, split2, isPB, isOverall, deltaMs);
  } 
  else if (stationId == 3 && useSz3) {
    if (checkpointMode) {
      uint8_t expected = RaceRules::getExpectedSectorForStation(
          stationId, useSz1, useSz2, useSz3);
      if (currentExpectedSector[carId] != expected) return;
    }
    if (sectorPassedInLap[carId] & (1 << 3)) return;
    sectorPassedInLap[carId] |= (1 << 3);

    uint32_t split3 = elapsedMs;
    uint32_t prevSplit = 0;
    if (useSz2 && (sectorPassedInLap[carId] & (1 << 2)) && split2TimeMs[carId] > 0) {
      prevSplit = split2TimeMs[carId];
    } else if (useSz1 && (sectorPassedInLap[carId] & (1 << 1)) && split1TimeMs[carId] > 0) {
      prevSplit = split1TimeMs[carId];
    }
    uint32_t s3 = (split3 > prevSplit) ? (split3 - prevSplit) : split3;

    split3TimeMs[carId] = split3;
    sz3TimeMs[carId] = s3;
    lastSectorTimeMs[carId] = timestampMs;
    if (checkpointMode) currentExpectedSector[carId] = RaceRules::getNextExpectedSector(stationId);

    bool isPB = false;
    bool isOverall = false;
    int32_t deltaMs = 0;

    if (!isOutSector) {
      if (bestSz3TimeMs[carId] > 0) {
        deltaMs = (int32_t)s3 - (int32_t)bestSz3TimeMs[carId];
        if (s3 < bestSz3TimeMs[carId]) { bestSz3TimeMs[carId] = s3; isPB = true; }
      } else {
        bestSz3TimeMs[carId] = s3;
        isPB = true;
      }

      if (overallBestSz3Ms == 0 || s3 < overallBestSz3Ms) {
        overallBestSz3Ms = s3;
        isOverall = true;
      }
    }
    broadcastSectorEvent(carId, 3, s3, split3, isPB, isOverall, deltaMs);
  }
}

void processValidLap(uint8_t carId, uint64_t exactSignalTimeMicros) {
  uint32_t exactMicros = (uint32_t)exactSignalTimeMicros;
  uint32_t nowMs = exactMicros / 1000UL;

  if (currentMode == MODE_DRAGRACE) {
    if (dragTrackOccupied) return;
    if (dragRunActive[carId]) return;
    if (lastCrossTime[carId] > 0 && (exactMicros - lastCrossTime[carId] < ((uint32_t)minLapTimeMs * 1000UL))) return;

    dragTrackOccupied = true;
    activeDragCarId = carId;
    dragRunActive[carId] = true;
    readyForNextLap[carId] = false;
    sectorPassedInLap[carId] = 0;

    lapCounter[carId] = (lapCounter[carId] == 0) ? 1 : lapCounter[carId];
    lastCrossTime[carId] = exactMicros;
    lastSectorTimeMs[carId] = nowMs;
    currentExpectedSector[carId] = 1;
    sz1TimeMs[carId] = 0; sz2TimeMs[carId] = 0; sz3TimeMs[carId] = 0; sz4TimeMs[carId] = 0;
    split1TimeMs[carId] = 0; split2TimeMs[carId] = 0; split3TimeMs[carId] = 0;

    LapStatusLeds::pulseReady();

    char startJson[128];
    snprintf(startJson, sizeof(startJson), "{\"type\":\"drag_start\",\"carId\":%d,\"driver\":\"%s\"}", carId, driverNames[carId].c_str());
    broadcastWebSocket(startJson);
    return;
  }

  if (lapCounter[carId] == 0) {
    if (RaceRules::isTimedMode(currentMode) &&
        !RaceRules::canAcceptTimedEventCross(
            modeEndTimeMs, millis(), lapCounter[carId], 0, finishedFinalLap[carId])) return;

    awaitingBaseCross[carId] = false;
    lastLapIsOutLap[carId] = false;
    inPitOrPause[carId] = false;
    pitEnteredMs[carId] = 0;
    isOutLap[carId] = false;
    sectorPassedInLap[carId] = 0;
    lapCounter[carId] = 1;
    lastCrossTime[carId] = exactMicros;
    lastSectorTimeMs[carId] = nowMs;
    readyForNextLap[carId] = false;
    currentExpectedSector[carId] = 1;
    sz1TimeMs[carId] = 0; sz2TimeMs[carId] = 0; sz3TimeMs[carId] = 0; sz4TimeMs[carId] = 0;
    split1TimeMs[carId] = 0; split2TimeMs[carId] = 0; split3TimeMs[carId] = 0;

    LapStatusLeds::pulseReady();

    char baseJson[128];
    snprintf(baseJson, sizeof(baseJson), "{\"type\":\"base_cross\",\"carId\":%d,\"driver\":\"%s\"}", carId, driverNames[carId].c_str());
    broadcastWebSocket(baseJson);
    return;
  }

  if (RaceRules::isTimedMode(currentMode)) {
    const uint32_t lapStartMs = lastCrossTime[carId] / 1000UL;
    if (!RaceRules::canAcceptTimedEventCross(
            modeEndTimeMs, millis(), lapCounter[carId], lapStartMs, finishedFinalLap[carId])) return;
  }

  if (RaceRules::isLapLimitExceeded(currentMode, lapCounter[carId], targetRounds)) return;

  if (checkpointMode && currentMode != MODE_DRAGRACE && lapCounter[carId] > 0) {
    if (!RaceRules::hasPassedAllCheckpoints(
            useSz1, useSz2, useSz3, currentExpectedSector[carId])) {
      currentExpectedSector[carId] = 1;
      sectorPassedInLap[carId] = 0;
      return;
    }
    currentExpectedSector[carId] = 1;
  }

  bool lapCounted = false;

  if (RaceRules::isLapTimeAboveMinimum(
          exactMicros - lastCrossTime[carId], minLapTimeMs) && readyForNextLap[carId]) {
    uint32_t currentLapTimeMs = (exactMicros - lastCrossTime[carId]) / 1000UL;
    
    uint32_t avgLap = getAverageLapTimeMs(carId);
    bool currentLapIsOutLap = isOutLap[carId] || inPitOrPause[carId];
    if (RaceRules::exceedsOutLapThreshold(avgLap, currentLapTimeMs, PIT_PAUSE_FACTOR_PERCENT)) {
      currentLapIsOutLap = true;
    }

    uint8_t finalSectorNum = RaceRules::getFinalSectorNumber(useSz1, useSz2, useSz3);

    if (finalSectorNum > 0 && lastSectorTimeMs[carId] > (lastCrossTime[carId] / 1000UL)) {
      uint32_t lastSplit = 0;
      if (finalSectorNum == 4 && (sectorPassedInLap[carId] & (1 << 3))) lastSplit = split3TimeMs[carId];
      else if (finalSectorNum == 3 && (sectorPassedInLap[carId] & (1 << 2))) lastSplit = split2TimeMs[carId];
      else if (finalSectorNum == 2 && (sectorPassedInLap[carId] & (1 << 1))) lastSplit = split1TimeMs[carId];

      if (RaceRules::hasFinalSectorRemainder(currentLapTimeMs, lastSplit)) {
        uint32_t sFinal = currentLapTimeMs - lastSplit;

        if (RaceRules::isValidSectorDuration(sFinal)) {
          bool isPB = false;
          bool isOverall = false;
          int32_t deltaMs = 0;

          if (!currentLapIsOutLap) {
            if (finalSectorNum == 4) {
              sz4TimeMs[carId] = sFinal;
              if (bestSz4TimeMs[carId] > 0) {
                deltaMs = (int32_t)sFinal - (int32_t)bestSz4TimeMs[carId];
                if (sFinal < bestSz4TimeMs[carId]) { bestSz4TimeMs[carId] = sFinal; isPB = true; }
              } else { bestSz4TimeMs[carId] = sFinal; isPB = true; }
              if (overallBestSz4Ms == 0 || sFinal < overallBestSz4Ms) { overallBestSz4Ms = sFinal; isOverall = true; }
            } 
            else if (finalSectorNum == 3) {
              sz3TimeMs[carId] = sFinal;
              split3TimeMs[carId] = currentLapTimeMs;
              if (bestSz3TimeMs[carId] > 0) {
                deltaMs = (int32_t)sFinal - (int32_t)bestSz3TimeMs[carId];
                if (sFinal < bestSz3TimeMs[carId]) { bestSz3TimeMs[carId] = sFinal; isPB = true; }
              } else { bestSz3TimeMs[carId] = sFinal; isPB = true; }
              if (overallBestSz3Ms == 0 || sFinal < overallBestSz3Ms) { overallBestSz3Ms = sFinal; isOverall = true; }
            } 
            else if (finalSectorNum == 2) {
              sz2TimeMs[carId] = sFinal;
              split2TimeMs[carId] = currentLapTimeMs;
              if (bestSz2TimeMs[carId] > 0) {
                deltaMs = (int32_t)sFinal - (int32_t)bestSz2TimeMs[carId];
                if (sFinal < bestSz2TimeMs[carId]) { bestSz2TimeMs[carId] = sFinal; isPB = true; }
              } else { bestSz2TimeMs[carId] = sFinal; isPB = true; }
              if (overallBestSz2Ms == 0 || sFinal < overallBestSz2Ms) { overallBestSz2Ms = sFinal; isOverall = true; }
            }
          } else {
            if (finalSectorNum == 4) sz4TimeMs[carId] = sFinal;
            else if (finalSectorNum == 3) { sz3TimeMs[carId] = sFinal; split3TimeMs[carId] = currentLapTimeMs; }
            else if (finalSectorNum == 2) { sz2TimeMs[carId] = sFinal; split2TimeMs[carId] = currentLapTimeMs; }
          }
          broadcastSectorEvent(carId, finalSectorNum, sFinal, currentLapTimeMs, isPB, isOverall, deltaMs, true);
        }
      }
    }

    lastLapDuration[carId] = currentLapTimeMs;
    bool isLapPB = false;
    bool isLapOverall = false;
    bool isNewTrackRecord = false;
    bool isNewDailyRecord = false;

    // Bestzeiten & Durchschnitt NUR aktualisieren, wenn es keine Outlap / Boxenrunde war!
    if (!currentLapIsOutLap) {
      addValidLapToAverage(carId, currentLapTimeMs);

      if (bestLapDuration[carId] > 0 && currentLapTimeMs < bestLapDuration[carId]) {
        bestLapDuration[carId] = currentLapTimeMs;
        isLapPB = true;
      } else if (bestLapDuration[carId] == 0) {
        bestLapDuration[carId] = currentLapTimeMs;
        isLapPB = true;
      }

      uint32_t currentOverallBestLap = 0;
      for (uint8_t c = 1; c <= MAX_CARS; c++) {
        if (c != carId && bestLapDuration[c] > 0 && (currentOverallBestLap == 0 || bestLapDuration[c] < currentOverallBestLap)) {
          currentOverallBestLap = bestLapDuration[c];
        }
      }
      if (isLapPB && (currentOverallBestLap == 0 || currentLapTimeMs < currentOverallBestLap)) {
        isLapOverall = true;
      }

      // --- STRECKENREKORD (TOP 5) & TAGESBESTZEIT (TOP 5) CHECK (Nur für rundenbasierte Events!) ---
      if (currentMode != MODE_DRAGRACE && currentLapTimeMs > 100) {
        uint32_t tempSz1 = (sectorPassedInLap[carId] & (1 << 1)) ? sz1TimeMs[carId] : 0;
        uint32_t tempSz2 = ((sectorPassedInLap[carId] & (1 << 2)) || finalSectorNum == 2) ? sz2TimeMs[carId] : 0;
        uint32_t tempSz3 = ((sectorPassedInLap[carId] & (1 << 3)) || finalSectorNum == 3) ? sz3TimeMs[carId] : 0;
        uint32_t tempSz4 = (finalSectorNum == 4) ? sz4TimeMs[carId] : 0;
        uint8_t curSzMask = (tempSz1 > 0 ? 1 : 0) | (tempSz2 > 0 ? 2 : 0) | (tempSz3 > 0 ? 4 : 0) | (tempSz4 > 0 ? 8 : 0);
        checkAndUpdateTrackRecords(carId, currentLapTimeMs, isNewTrackRecord, isNewDailyRecord, tempSz1, tempSz2, tempSz3, tempSz4, curSzMask);
      }
    }
    
    // Gültige Sektorzeiten dieser Runde für die Statistik sichern
    uint32_t savedSz1 = (sectorPassedInLap[carId] & (1 << 1)) ? sz1TimeMs[carId] : 0;
    uint32_t savedSz2 = ((sectorPassedInLap[carId] & (1 << 2)) || finalSectorNum == 2) ? sz2TimeMs[carId] : 0;
    uint32_t savedSz3 = ((sectorPassedInLap[carId] & (1 << 3)) || finalSectorNum == 3) ? sz3TimeMs[carId] : 0;
    uint32_t savedSz4 = (finalSectorNum == 4) ? sz4TimeMs[carId] : 0;

    uint16_t completedLap = lapCounter[carId];
    lapCounter[carId]++;
    lastCrossTime[carId] = exactMicros;
    lastSectorTimeMs[carId] = nowMs;
    readyForNextLap[carId] = false;
    currentExpectedSector[carId] = 1;
    
    lastLapIsOutLap[carId] = currentLapIsOutLap;
    inPitOrPause[carId] = false;
    pitEnteredMs[carId] = 0;
    isOutLap[carId] = false;
    sectorPassedInLap[carId] = 0;
    split1TimeMs[carId] = 0; split2TimeMs[carId] = 0; split3TimeMs[carId] = 0;
    
    lapCounted = true;

    if (RaceRules::isTimedMode(currentMode) && modeEndTimeMs > 0 && millis() > modeEndTimeMs) {
      finishedFinalLap[carId] = true;
    }

    uint64_t currentTsMs = getCurrentTimestampMs();
    uint8_t pos = getCurrentPosition(carId);
    
    queueLapForStorage(carId, completedLap, currentLapTimeMs, savedSz1, savedSz2, savedSz3, savedSz4, pos, (uint8_t)currentMode, currentTsMs, currentLapIsOutLap);

    bool ghostBeaten = false;
    int32_t ghostDelta = 0;
    if (currentMode == MODE_GHOST_HUNT && !currentLapIsOutLap && currentLapTimeMs > 100) {
      uint8_t curSzMask = (savedSz1 > 0 ? 1 : 0) | (savedSz2 > 0 ? 2 : 0) | (savedSz3 > 0 ? 4 : 0) | (savedSz4 > 0 ? 8 : 0);
      if (ghostLapMs == 0) {
        setGhostTarget(ghostTargetType, currentLapTimeMs, savedSz1, savedSz2, savedSz3, savedSz4, curSzMask, driverNames[carId], carNames[carId], carId);
        ghostBeaten = true;
      } else if (currentLapTimeMs < ghostLapMs) {
        ghostDelta = (int32_t)currentLapTimeMs - (int32_t)ghostLapMs;
        setGhostTarget(ghostTargetType, currentLapTimeMs, savedSz1, savedSz2, savedSz3, savedSz4, curSzMask, driverNames[carId], carNames[carId], carId);
        ghostBeaten = true;
      } else {
        ghostDelta = (int32_t)currentLapTimeMs - (int32_t)ghostLapMs;
      }
    }
    broadcastLapEvent(carId, completedLap, currentLapTimeMs, pos, isLapPB, isLapOverall, isNewTrackRecord, isNewDailyRecord, currentLapIsOutLap);
    if (currentMode == MODE_GHOST_HUNT) {
      if (ghostBeaten) {
        playBuzzerGhostVictory();
        char gBeatenBuf[240];
        uint8_t curSzMask = (savedSz1 > 0 ? 1 : 0) | (savedSz2 > 0 ? 2 : 0) | (savedSz3 > 0 ? 4 : 0) | (savedSz4 > 0 ? 8 : 0);
        snprintf(gBeatenBuf, sizeof(gBeatenBuf),
          "{\"type\":\"ghost_beaten\",\"carId\":%d,\"driver\":\"%s\",\"lapTime\":%lu,\"ghostLap\":%lu,\"delta\":%ld,\"s1\":%lu,\"s2\":%lu,\"s3\":%lu,\"s4\":%lu,\"szMask\":%d}",
          carId, driverNames[carId].c_str(), (unsigned long)currentLapTimeMs, (unsigned long)ghostLapMs, (long)ghostDelta,
          (unsigned long)savedSz1, (unsigned long)savedSz2, (unsigned long)savedSz3, (unsigned long)savedSz4, curSzMask);
        broadcastWebSocket(gBeatenBuf);
      } else if (ghostAudioEnabled) {
        if (ghostDelta <= 0) playBuzzerGhostAhead();
        else playBuzzerGhostBehind();
      } else {
        playBuzzerLap();
      }
    } else if (isNewTrackRecord || isLapOverall) {
      playBuzzerRecord();
    } else {
      playBuzzerLap();
    }
  }

  if (lapCounted) {
    LapStatusLeds::pulseReady();
  }
}
void processLapInputFrame(uint8_t carId, uint32_t exactSignalTime, bool confirmed) {
  if (carId > MAX_CARS) return;
  lastSeenMs[carId] = millis();
  if (!confirmed) return;

  addRecentID(carId);
  processValidLap(carId, exactSignalTime);
}

void updateLapLogicTasks() {
  uint32_t now = millis();
  for (uint8_t i = 1; i <= MAX_CARS; i++) {
    if (!readyForNextLap[i] && (now - lastSeenMs[i] > CLEARANCE_TIMEOUT_MS)) {
      readyForNextLap[i] = true; 
    }

    if (currentMode != MODE_DRAGRACE && lapCounter[i] > 0 && !finishedFinalLap[i] && !inPitOrPause[i] && !isOutLap[i]) {
      uint32_t avgMs = getAverageLapTimeMs(i);
      if (avgMs > 0 && lastCrossTime[i] > 0) {
        uint32_t lapStartMs = lastCrossTime[i] / 1000UL;
        if (now > lapStartMs) {
          uint32_t currentElapsedMs = now - lapStartMs;
          if (RaceRules::exceedsOutLapThreshold(avgMs, currentElapsedMs, PIT_PAUSE_FACTOR_PERCENT)) {
            inPitOrPause[i] = true;
            if (pitEnteredMs[i] == 0) {
              pitEnteredMs[i] = now;
            }
          }
        }
      }
    }
  }

  if (currentMode == MODE_DRAGRACE) {
    for (uint8_t i = 1; i <= MAX_CARS; i++) {
      if (dragRunActive[i] && (now - lastSectorTimeMs[i] > 45000UL)) {
        dragRunActive[i] = false;
        readyForNextLap[i] = true;
        if (activeDragCarId == i) {
          dragTrackOccupied = false;
          activeDragCarId = 0;
        }
      }
    }
  }
  
  static bool sessionEndBroadcasted = false;
  if (RaceRules::isTimedMode(currentMode)) {
    if (modeEndTimeMs > 0 && now > modeEndTimeMs) {
      if (!sessionEndBroadcasted && areAllActiveCarsFinished()) {
        sessionEndBroadcasted = true;
        flushCurrentSessionToIndex();
        broadcastWebSocket("{\"type\":\"session_completed\"}");
      }
    } else {
      sessionEndBroadcasted = false;
    }
  } else {
    sessionEndBroadcasted = false;
  }

  checkDailyBestDateRollover();
}
