SirDomsen/RC-LAP-TIMER-PRO/esp8266_rx/src/web_handlers.cpp

#include "web_handlers.h"
#include "storage.h"
#include "lap_logic.h"
#include "esp_now_base.h"
#include "web_server.h"
#include "buzzer.h"
#include <ir_decoder.h>
#include <network_platform.h>

#if defined(ESP8266)
#include <LittleFS.h>
#include <ArduinoJson.h>
#include <sys/time.h>
#include <utime.h>
extern "C" {
  #include <espnow.h>
}
#elif defined(ESP32)
#include <LittleFS.h>
#include <ArduinoJson.h>
#include <sys/time.h>
#include <utime.h>
#include <esp_now.h>
#endif

void handleGetLaps(AsyncWebServerRequest *request) {
  if (isHeapCriticalForFileTransfer()) {
    AsyncWebServerResponse *res = request->beginResponse(503, "application/json", "{\"error\":\"busy\"}");
    res->addHeader("Retry-After", "2");
    res->addHeader("Connection", "close");
    request->send(res);
    return;
  }
  AsyncResponseStream *response = request->beginResponseStream("application/json");
  response->print("[");
  bool first = true;
  for (uint8_t i = 1; i <= MAX_CARS; i++) {
    if (lapCounter[i] > 0 || sz1TimeMs[i] > 0 || sz2TimeMs[i] > 0 || sz3TimeMs[i] > 0 || sz4TimeMs[i] > 0 || bestSz1TimeMs[i] > 0 || bestSz2TimeMs[i] > 0 || bestSz3TimeMs[i] > 0 || bestSz4TimeMs[i] > 0 || !awaitingBaseCross[i]) {
      if (!first) response->print(",");
      
      const char* stateStr = "normal";
      if (currentMode == MODE_DRAGRACE) {
        stateStr = dragRunActive[i] ? "drag_running" : "normal";
      } else if (isOutLap[i]) {
        stateStr = "outlap";
      } else if (inPitOrPause[i]) {
        stateStr = (currentMode == MODE_PRACTICE) ? "pause" : "box";
      } else if (lapCounter[i] == 0 && !awaitingBaseCross[i]) {
        stateStr = "outlap";
      }

      response->printf("{\"id\":%d,\"driver\":\"%s\",\"car\":\"%s\",\"completedLaps\":%d,",
                       i, driverNames[i].c_str(), carNames[i].c_str(), (lapCounter[i] > 0 ? (lapCounter[i] - 1) : 0));
      response->printf("\"sz1\":%lu,\"sz2\":%lu,\"sz3\":%lu,\"sz4\":%lu,", 
                       (unsigned long)sz1TimeMs[i], (unsigned long)sz2TimeMs[i], (unsigned long)sz3TimeMs[i], (unsigned long)sz4TimeMs[i]);
      response->printf("\"bestSz1\":%lu,\"bestSz2\":%lu,\"bestSz3\":%lu,\"bestSz4\":%lu,", 
                       (unsigned long)bestSz1TimeMs[i], (unsigned long)bestSz2TimeMs[i], (unsigned long)bestSz3TimeMs[i], (unsigned long)bestSz4TimeMs[i]);
      response->printf("\"split1\":%lu,\"split2\":%lu,\"split3\":%lu,", 
                       (unsigned long)split1TimeMs[i], (unsigned long)split2TimeMs[i], (unsigned long)split3TimeMs[i]);
      response->printf("\"lastLap\":%lu,\"bestLap\":%lu,\"avgLap\":%lu,\"lastLapIsOutLap\":%s,\"lastSeenMs\":%lu,\"state\":\"%s\"}",
                       (unsigned long)lastLapDuration[i], (unsigned long)bestLapDuration[i], (unsigned long)getAverageLapTimeMs(i), lastLapIsOutLap[i] ? "true" : "false", (unsigned long)lastSeenMs[i], stateStr);
      first = false;
    }
  }
  response->print("]");
  request->send(response);
}

void handleGetStationsStatus(AsyncWebServerRequest *request) {
  checkDailyBestDateRollover();
  String json;
  json.reserve(160);
  json = "{";
  json += "\"sz1\":" + String(isStationOnline(1) ? "true" : "false") + ",";
  json += "\"sz2\":" + String(isStationOnline(2) ? "true" : "false") + ",";
  json += "\"sz3\":" + String(isStationOnline(3) ? "true" : "false") + ",";
  json += "\"sz1Bat\":" + String(isStationBatteryLow(1) ? "true" : "false") + ",";
  json += "\"sz2Bat\":" + String(isStationBatteryLow(2) ? "true" : "false") + ",";
  json += "\"sz3Bat\":" + String(isStationBatteryLow(3) ? "true" : "false") + ",";
  json += "\"sz1Uni\":" + String(isStationUnicast(1) ? "true" : "false") + ",";
  json += "\"sz2Uni\":" + String(isStationUnicast(2) ? "true" : "false") + ",";
  json += "\"sz3Uni\":" + String(isStationUnicast(3) ? "true" : "false");
  json += "}";
  request->send(200, "application/json", json);
}

void handlePostSession(AsyncWebServerRequest *request) {
  if (request->hasParam("mode")) {
    int mode = request->getParam("mode")->value().toInt();
    RaceMode newMode = (RaceMode)mode;

    resetAllLaps(false);

    currentMode = newMode;
    startNewSessionFrame((uint8_t)newMode);
    
    uint16_t duration = request->hasParam("duration") ? request->getParam("duration")->value().toInt() : 0;
    targetRounds = request->hasParam("laps") ? request->getParam("laps")->value().toInt() : 0;

    if (duration > 0) {
      modeEndTimeMs = millis() + ((uint32_t)duration * 60000UL);
    } else {
      modeEndTimeMs = 0;
    }

    for (uint8_t i = 0; i <= MAX_CARS; i++) {
      finishedFinalLap[i] = false;
      inPitOrPause[i] = false;
      isOutLap[i] = false;
    }
    dragTrackOccupied = false;
    activeDragCarId = 0;

    if (newMode == MODE_GHOST_HUNT) {
      uint8_t gType = request->hasParam("ghostType") ? request->getParam("ghostType")->value().toInt() : 0;
      uint32_t gLap = request->hasParam("ghostLap") ? request->getParam("ghostLap")->value().toInt() : 0;
      uint32_t gS1 = request->hasParam("ghostS1") ? request->getParam("ghostS1")->value().toInt() : 0;
      uint32_t gS2 = request->hasParam("ghostS2") ? request->getParam("ghostS2")->value().toInt() : 0;
      uint32_t gS3 = request->hasParam("ghostS3") ? request->getParam("ghostS3")->value().toInt() : 0;
      uint32_t gS4 = request->hasParam("ghostS4") ? request->getParam("ghostS4")->value().toInt() : 0;
      uint8_t gMask = request->hasParam("ghostMask") ? request->getParam("ghostMask")->value().toInt() : 0;
      uint8_t gCarId = request->hasParam("ghostCarId") ? request->getParam("ghostCarId")->value().toInt() : 0;
      String gDriver = request->hasParam("ghostDriver") ? request->getParam("ghostDriver")->value() : "";
      String gCar = request->hasParam("ghostCar") ? request->getParam("ghostCar")->value() : "";

      if (gLap == 0) {
        if (gType == 0 && allTimeBestLapMs > 0) {
          gLap = allTimeBestLapMs;
          gS1 = allTimeBestS1Ms;
          gS2 = allTimeBestS2Ms;
          gS3 = allTimeBestS3Ms;
          gS4 = allTimeBestS4Ms;
          gMask = allTimeBestSzMask;
          gDriver = allTimeBestDriver;
          gCar = allTimeBestCar;
          gCarId = allTimeBestCarId;
        } else if (gType == 1 && dailyBestLapMs > 0) {
          gLap = dailyBestLapMs;
          gS1 = dailyBestS1Ms;
          gS2 = dailyBestS2Ms;
          gS3 = dailyBestS3Ms;
          gS4 = dailyBestS4Ms;
          gMask = dailyBestSzMask;
          gDriver = dailyBestDriver;
          gCar = dailyBestCar;
          gCarId = dailyBestCarId;
        }
      }
      setGhostTarget(gType, gLap, gS1, gS2, gS3, gS4, gMask, gDriver, gCar, gCarId);
    }

    char startJson[128];
    snprintf(startJson, sizeof(startJson),
             "{\"type\":\"session_start\",\"mode\":%d,\"duration\":%d,\"laps\":%d}",
             (int)currentMode, duration, targetRounds);
    broadcastWebSocket(startJson);
  }
  request->send(200, "text/plain", "OK");
}

void handleGetTimeLeft(AsyncWebServerRequest *request) {
  int32_t secondsLeft = -1;
  if (modeEndTimeMs > 0) {
    if (millis() < modeEndTimeMs) {
      secondsLeft = (modeEndTimeMs - millis()) / 1000;
    } else {
      secondsLeft = 0;
    }
  }
  checkDailyBestDateRollover();
  String json;
  json.reserve(850);
  json = "{\"mode\":";
  json += (int)currentMode;
  json += ",\"secondsLeft\":";
  json += secondsLeft;
  json += ",\"serverMillis\":";
  json += millis();
  json += ",\"allFinished\":";
  json += (areAllActiveCarsFinished() ? "true" : "false");
  json += ",\"targetLaps\":";
  json += targetRounds;
  json += ",\"dragOccupied\":";
  json += (dragTrackOccupied ? "true" : "false");
  json += ",\"activeDragCar\":";
  json += activeDragCarId;
  json += ",\"recordLap\":";
  json += allTimeBestLapMs;
  json += ",\"recordCarId\":";
  json += allTimeBestCarId;
  json += ",\"recordDriver\":\"";
  json += allTimeBestDriver;
  json += "\",\"recordCar\":\"";
  json += allTimeBestCar;
  json += "\",\"recordDate\":\"";
  json += allTimeBestDate;
  json += "\",\"dailyBestLap\":";
  json += dailyBestLapMs;
  json += ",\"dailyBestCarId\":";
  json += dailyBestCarId;
  json += ",\"dailyBestDriver\":\"";
  json += dailyBestDriver;
  json += "\",\"dailyBestCar\":\"";
  json += dailyBestCar;
  json += "\",\"dailyBestDate\":\"";
  json += dailyBestDate;
  json += "\",\"activeTrackId\":\"";
  json += activeTrackId;
  json += "\",\"activeTrackName\":\"";
  json += activeTrackName;
  json += "\",\"ghostLap\":";
  json += ghostLapMs;
  json += ",\"ghostType\":";
  json += ghostTargetType;
  json += ",\"ghostDriver\":\"";
  json += ghostDriverName;
  json += "\",\"ghostCar\":\"";
  json += ghostCarName;
  json += "\",\"ghostSzMask\":";
  json += ghostSzMask;
  json += ",\"ghostS1\":";
  json += ghostS1Ms;
  json += ",\"ghostS2\":";
  json += ghostS2Ms;
  json += ",\"ghostS3\":";
  json += ghostS3Ms;
  json += ",\"ghostS4\":";
  json += ghostS4Ms;
  json += ",\"recordSzMask\":";
  json += allTimeBestSzMask;
  json += ",\"recordS1\":";
  json += allTimeBestS1Ms;
  json += ",\"recordS2\":";
  json += allTimeBestS2Ms;
  json += ",\"recordS3\":";
  json += allTimeBestS3Ms;
  json += ",\"recordS4\":";
  json += allTimeBestS4Ms;
  json += ",\"dailySzMask\":";
  json += dailyBestSzMask;
  json += ",\"dailyS1\":";
  json += dailyBestS1Ms;
  json += ",\"dailyS2\":";
  json += dailyBestS2Ms;
  json += ",\"dailyS3\":";
  json += dailyBestS3Ms;
  json += ",\"dailyS4\":";
  json += dailyBestS4Ms;
  json += ",\"fsPct\":";
  json += cachedFsUsedPct;
  json += ",\"fsFull\":";
  json += (storageFullLocked || cachedFsUsedPct >= 95 ? "true" : "false");
  json += ",\"fsUsed\":";
  json += cachedFsUsedBytes;
  json += ",\"fsTotal\":";
  json += cachedFsTotalBytes;
  json += "}";
  request->send(200, "application/json", json);
}

void handleGetRecent(AsyncWebServerRequest *request) {
  checkDailyBestDateRollover();
  String json;
  json.reserve(64);
  json = "[";
  for (int i = 0; i < 5; i++) {
    json += recentIDs[i];
    if (i < 4) json += ",";
  }
  json += "]";
  request->send(200, "application/json", json);
}

void handleGetDeadtime(AsyncWebServerRequest *request) {
  checkDailyBestDateRollover();
  String json;
  json.reserve(32);
  json = "{\"ms\":";
  json += minLapTimeMs;
  json += "}";
  request->send(200, "application/json", json);
}

void handleGetFilter(AsyncWebServerRequest *request) {
  checkDailyBestDateRollover();
  String json;
  json.reserve(32);
  json = "{\"enabled\":";
  json += (IrDecoder::isTwoFrameFilterEnabled() ? "true" : "false");
  json += "}";
  request->send(200, "application/json", json);
}

void handleGetNames(AsyncWebServerRequest *request) {
  AsyncResponseStream *response = request->beginResponseStream("application/json");
  response->print("{");
  for (uint8_t i = 1; i <= MAX_CARS; i++) {
    if (i > 1) response->print(",");
    response->printf("\"%d\":{\"driver\":\"%s\",\"car\":\"%s\"}", i, driverNames[i].c_str(), carNames[i].c_str());
  }
  response->print("}");
  request->send(response);
}

void handleGetNameHistory(AsyncWebServerRequest *request) {
  if (!LittleFS.exists("/names_history.jsonl")) {
    request->send(200, "application/x-ndjson", "");
    return;
  }
  AsyncWebServerResponse *response = request->beginResponse(LittleFS, "/names_history.jsonl", "application/x-ndjson");
  response->addHeader("Cache-Control", "no-cache, no-store, must-revalidate");
  request->send(response);
}

void handleGetVersion(AsyncWebServerRequest *request) {
  checkDailyBestDateRollover();
  String json;
  json.reserve(64);
  json = "{\"firmware\":\"" FIRMWARE_VERSION "\"}";
  request->send(200, "application/json", json);
}

void handlePostSetFilter(AsyncWebServerRequest *request) {
  if (request->hasParam("enable")) {
    bool enable = (request->getParam("enable")->value() == "1");
    IrDecoder::setTwoFrameFilterEnabled(enable);
    saveFilterToEEPROM(enable);
  }
  request->send(200, "text/plain", "OK");
}

void handlePostSetDeadtime(AsyncWebServerRequest *request) {
  if (request->hasParam("ms")) {
    uint16_t ms = request->getParam("ms")->value().toInt();
    if (ms >= 500 && ms <= 30000) {
      minLapTimeMs = ms;
      saveDeadtimeToEEPROM(ms);
    }
  }
  request->send(200, "text/plain", "OK");
}

void handlePostRename(AsyncWebServerRequest *request) {
  if (request->hasParam("id")) {
    int id = request->getParam("id")->value().toInt();
    String driver = request->hasParam("driver") ? request->getParam("driver")->value() : driverNames[id];
    String car = request->hasParam("car") ? request->getParam("car")->value() : carNames[id];
    
    if (id >= 1 && id <= MAX_CARS) {
      if (!saveNamesToEEPROM(id, driver, car)) {
        request->send(500, "text/plain", "Fahrer-/Auto-Zuordnung konnte nicht dauerhaft gespeichert werden.");
        return;
      }
      if (dailyBestCarId == id || allTimeBestCarId == id) {
        if (dailyBestCarId == id) {
          dailyBestDriver = driver;
          dailyBestCar = car;
        }
        if (allTimeBestCarId == id) {
          allTimeBestDriver = driver;
          allTimeBestCar = car;
        }
        saveDailyBest();
      }
    }
  }
  request->send(200, "text/plain", "OK");
}

void handlePostReset(AsyncWebServerRequest *request) {
  bool hard = true;
  if (request->hasParam("hard")) {
    hard = (request->getParam("hard")->value() == "1");
  }
  resetAllLaps(hard);
  request->send(200, "text/plain", "OK");
}

void handlePostSyncTime(AsyncWebServerRequest *request) {
  if (request->hasParam("tz")) {
    clientTzOffsetSec = request->getParam("tz")->value().toInt();
  }
  if (request->hasParam("ts")) {
    uint64_t clientTsSec = strtoull(request->getParam("ts")->value().c_str(), NULL, 10);
    syncClockOnce(clientTsSec);
  }
  request->send(200, "text/plain", "OK");
}

void handleGetSessions(AsyncWebServerRequest *request) {
  flushCurrentSessionToIndex();
  updateFsUsageCache();
  String filepath = "/sessions.json";
  if (!LittleFS.exists(filepath) && LittleFS.exists("/sessions.tmp")) {
    filepath = "/sessions.tmp";
  }
  if (LittleFS.exists(filepath)) {
    AsyncWebServerResponse *response = request->beginResponse(LittleFS, filepath, "application/json");
    response->addHeader("Cache-Control", "no-cache, no-store, must-revalidate");
    response->addHeader("Pragma", "no-cache");
    response->addHeader("Expires", "0");
    request->send(response);
  } else {
    AsyncWebServerResponse *response = request->beginResponse(200, "application/json", "{\"sessions\":[]}");
    response->addHeader("Cache-Control", "no-cache, no-store, must-revalidate");
    response->addHeader("Pragma", "no-cache");
    response->addHeader("Expires", "0");
    request->send(response);
  }
}

void handleGetSessionFile(AsyncWebServerRequest *request) {
  flushCurrentSessionToIndex();
  if (request->hasParam("file")) {
    String fn = request->getParam("file")->value();
    fn.replace("%2F", "/");
    fn.replace("%2f", "/");
    if (!fn.startsWith("/")) fn = "/" + fn;
    if (fn.indexOf("..") < 0 && LittleFS.exists(fn)) {
      AsyncWebServerResponse *response = request->beginResponse(LittleFS, fn, "application/json");
      response->addHeader("Cache-Control", "no-cache, no-store, must-revalidate");
      response->addHeader("Pragma", "no-cache");
      response->addHeader("Expires", "0");
      request->send(response);
      return;
    }
  }
  AsyncWebServerResponse *response = request->beginResponse(404, "application/json", "{\"laps\":[]}");
  response->addHeader("Cache-Control", "no-cache, no-store, must-revalidate");
  request->send(response);
}

void handlePostDeleteLap(AsyncWebServerRequest *request) {
  if (request->hasParam("sessionId") || request->hasParam("file")) {
    String sessionId = request->hasParam("sessionId") ? request->getParam("sessionId")->value() : "";
    String filePath = request->hasParam("file") ? request->getParam("file")->value() : "";
    uint8_t id = request->hasParam("id") ? (uint8_t)request->getParam("id")->value().toInt() : 0;
    uint16_t lap = request->hasParam("lap") ? (uint16_t)request->getParam("lap")->value().toInt() : 0;
    uint32_t lapTime = request->hasParam("time") ? (uint32_t)request->getParam("time")->value().toInt() : 0;
    deleteLapFromSession(sessionId, filePath, id, lap, lapTime);
    request->send(200, "text/plain", "OK");
  } else {
    request->send(400, "text/plain", "Bad Request");
  }
}

void handlePostDeleteDriverStats(AsyncWebServerRequest *request) {
  if (request->hasParam("id")) {
    uint8_t id = request->getParam("id")->value().toInt();
    deleteDriverHistory(id);
    request->send(200, "text/plain", "OK");
  } else {
    request->send(400, "text/plain", "Bad Request");
  }
}

void handlePostDeleteAllStats(AsyncWebServerRequest *request) {
  deleteAllHistory();
  request->send(200, "text/plain", "OK");
}

void handlePostDeleteSession(AsyncWebServerRequest *request) {
  if (request->hasParam("id")) {
    String sessionId = request->getParam("id")->value();
    deleteSessionById(sessionId);
    request->send(200, "text/plain", "OK");
  } else {
    request->send(400, "text/plain", "Bad Request");
  }
}


// --- STRECKEN-HANDLERS & TOP-5 REKORDVERWALTUNG ---
void handleGetTracks(AsyncWebServerRequest *request) {
  checkDailyBestDateRollover();
  if (LittleFS.exists("/tracks.json")) {
    request->send(LittleFS, "/tracks.json", "application/json");
  } else {
    saveTracksToFS();
    if (LittleFS.exists("/tracks.json")) {
      request->send(LittleFS, "/tracks.json", "application/json");
    } else {
      request->send(200, "application/json", "{\"active\":\"standard\",\"tracks\":[{\"id\":\"standard\",\"name\":\"Test-Strecke\",\"recordLap\":0,\"bestLap\":0,\"allTimeRecords\":[],\"dailyRecords\":[]}]}");
    }
  }
}

void handlePostSelectTrack(AsyncWebServerRequest *request) {
  if (request->hasParam("id")) {
    String id = request->getParam("id")->value();
    if (selectTrackById(id)) {
      request->send(200, "text/plain", "OK");
      return;
    }
  }
  request->send(400, "text/plain", "Strecke nicht gefunden");
}

void handlePostAddTrack(AsyncWebServerRequest *request) {
  String name = "";
  if (request->hasParam("name")) {
    name = request->getParam("name")->value();
  } else if (request->hasParam("name", true)) {
    name = request->getParam("name", true)->value();
  }
  if (name.length() > 0 && addOrSelectTrack(name)) {
    request->send(200, "text/plain", activeTrackId);
  } else {
    request->send(400, "text/plain", "Ungueltiger Streckenname");
  }
}

void handlePostDeleteTrack(AsyncWebServerRequest *request) {
  if (request->hasParam("id")) {
    String id = request->getParam("id")->value();
    if (deleteTrackById(id)) {
      request->send(200, "text/plain", activeTrackId);
      return;
    }
  }
  request->send(400, "text/plain", "Fehler beim Loeschen");
}

void handlePostDeleteTrackRecord(AsyncWebServerRequest *request) {
  String trackId = request->hasParam("trackId") ? request->getParam("trackId")->value() : activeTrackId;
  String typeStr = request->hasParam("type") ? request->getParam("type")->value() : "daily";
  int8_t idx = request->hasParam("index") ? (int8_t)request->getParam("index")->value().toInt() : 0;

  bool isDaily = (typeStr == "daily");
  if (deleteTrackRecordEntry(trackId, isDaily, idx)) {
    request->send(200, "text/plain", "OK");
  } else {
    request->send(400, "text/plain", "Eintrag nicht gefunden");
  }
}

void handleGetSectorConfig(AsyncWebServerRequest *request) {
  checkDailyBestDateRollover();
  String json;
  json.reserve(160);
  json = "{";
  json += "\"useSz1\":" + String(useSz1 ? "true" : "false") + ",";
  json += "\"useSz2\":" + String(useSz2 ? "true" : "false") + ",";
  json += "\"useSz3\":" + String(useSz3 ? "true" : "false") + ",";
  json += "\"checkpointMode\":" + String(checkpointMode ? "true" : "false") + ",";
  json += "\"dragraceMode\":" + String(dragraceMode ? "true" : "false") + ",";
  json += "\"sectorAudio\":" + String(sectorAudioFeedback ? "true" : "false") + ",";
  json += "\"ghostAudio\":" + String(ghostAudioEnabled ? "true" : "false");
  json += "}";
  request->send(200, "application/json", json);
}

void handlePostSetSectorConfig(AsyncWebServerRequest *request) {
  if (request->hasParam("sz1"))   useSz1 = (request->getParam("sz1")->value() == "1");
  if (request->hasParam("sz2"))   useSz2 = (request->getParam("sz2")->value() == "1");
  if (request->hasParam("sz3"))   useSz3 = (request->getParam("sz3")->value() == "1");
  if (request->hasParam("cp"))    checkpointMode = (request->getParam("cp")->value() == "1");
  if (request->hasParam("dr"))    dragraceMode = (request->getParam("dr")->value() == "1");
  if (request->hasParam("audio")) sectorAudioFeedback = (request->getParam("audio")->value() == "1");
  if (request->hasParam("ghostAudio")) ghostAudioEnabled = (request->getParam("ghostAudio")->value() == "1");

  saveSectorConfigToEEPROM(useSz1, useSz2, useSz3, checkpointMode, dragraceMode, sectorAudioFeedback);
  request->send(200, "text/plain", "OK");
}

static File uploadFile;

void handleGetDebugPackets(AsyncWebServerRequest *request) {
  request->send(200, "application/json", getDebugPacketsJSON());
}

void handleGetDebugStatus(AsyncWebServerRequest *request) {
  request->send(200, "application/json", getDebugMode() ? "{\"debug\":true}" : "{\"debug\":false}");
}

void handlePostSetDebugMode(AsyncWebServerRequest *request) {
  if (request->hasParam("active")) {
    bool active = (request->getParam("active")->value() == "1");
    setDebugMode(active);
  }
  request->send(200, "text/plain", "OK");
}

void handleFileUpload(AsyncWebServerRequest *request, const String& filename, size_t index, uint8_t *data, size_t len, bool final) {
  static char cleanPath[64];
  static uint32_t targetMtime = 0;

  if (!index) {
    targetMtime = 0;
    if (request->hasParam("mtime")) {
      targetMtime = strtoul(request->getParam("mtime")->value().c_str(), NULL, 10);
    }

    if (!filename.startsWith("/")) {
      snprintf(cleanPath, sizeof(cleanPath), "/%s", filename.c_str());
    } else {
      snprintf(cleanPath, sizeof(cleanPath), "%s", filename.c_str());
    }

    String pathStr = String(cleanPath);
    int slashIdx = pathStr.indexOf('/', 1);
    while (slashIdx > 0) {
      String dirPart = pathStr.substring(0, slashIdx);
      if (!LittleFS.exists(dirPart)) {
        LittleFS.mkdir(dirPart);
      }
      slashIdx = pathStr.indexOf('/', slashIdx + 1);
    }
    
    if (strstr(cleanPath, ".gz") != NULL) {
      char rawPath[64];
      strncpy(rawPath, cleanPath, sizeof(rawPath));
      char *gzExt = strstr(rawPath, ".gz");
      if (gzExt) *gzExt = '\0';
      if (LittleFS.exists(rawPath)) {
        LittleFS.remove(rawPath);
      }
    }

    uploadFile = LittleFS.open(cleanPath, "w");
  }
  
  if (uploadFile) {
    uploadFile.write(data, len);
  }
  
  if (final) {
    if (uploadFile) {
      timeval oldTv;
      bool timeSwapped = false;
      if (targetMtime > 0) {
        gettimeofday(&oldTv, nullptr);
        timeval newTv = { (time_t)targetMtime, 0 };
        settimeofday(&newTv, nullptr);
        timeSwapped = true;
      }

      uploadFile.close();

      if (timeSwapped) {
        settimeofday(&oldTv, nullptr);
      }

      if (filename.indexOf("names.json") >= 0) {
        loadNamesFromFS();
      } else if (filename.indexOf("tracks.json") >= 0) {
        loadTracksFromFS();
      }
      updateFsUsageCache();
    }
  }
}



void handleGetAllConfig(AsyncWebServerRequest *request) {
  checkDailyBestDateRollover();
  AsyncResponseStream *response = request->beginResponseStream("application/json");

  response->print("{\"wifi\":{");
  response->printf("\"runtimeMode\":%d,", currentRuntimeWifiMode);
  response->printf("\"mode\":%d,", activeWifiMode);
  response->printf("\"homeSSID\":\"%s\",", homeSSID.c_str());
  response->printf("\"homePass\":\"%s\",", homePass.c_str());
  response->printf("\"hotspotSSID\":\"%s\",", hotspotSSID.c_str());
  response->printf("\"hotspotPass\":\"%s\",", hotspotPass.c_str());
  response->printf("\"apSSID\":\"%s\",", apSSID.c_str());
  response->printf("\"apPass\":\"%s\",", apPass.c_str());
  String curIP = (currentRuntimeWifiMode == 0) ? NetworkPlatform::accessPointIP().toString() : NetworkPlatform::stationIP().toString();
  String lIP = (learnedApIP.length() > 0) ? learnedApIP : "192.168.0.8";
  response->printf("\"currentIP\":\"%s\",", curIP.c_str());
  response->printf("\"learnedApIP\":\"%s\",", lIP.c_str());
  response->printf("\"defaultApSSID\":\"%s\"", getDefaultApSSID().c_str());
  response->print("},");

  response->printf("\"deadtime\":{\"ms\":%u},", minLapTimeMs);
  response->printf("\"filter\":{\"enabled\":%s},", IrDecoder::isTwoFrameFilterEnabled() ? "true" : "false");

  response->print("\"sector\":{");
  response->printf("\"useSz1\":%s,", useSz1 ? "true" : "false");
  response->printf("\"useSz2\":%s,", useSz2 ? "true" : "false");
  response->printf("\"useSz3\":%s,", useSz3 ? "true" : "false");
  response->printf("\"checkpointMode\":%s,", checkpointMode ? "true" : "false");
  response->printf("\"dragraceMode\":%s,", dragraceMode ? "true" : "false");
  response->printf("\"sectorAudio\":%s", sectorAudioFeedback ? "true" : "false");
  response->print("},");

  response->print("\"names\":{");
  for (uint8_t i = 1; i <= MAX_CARS; i++) {
    if (i > 1) response->print(",");
    response->printf("\"%d\":{\"driver\":\"%s\",\"car\":\"%s\"}", i, driverNames[i].c_str(), carNames[i].c_str());
  }
  response->print("}}");

  request->send(response);
}

void handleGetWifiConfig(AsyncWebServerRequest *request) {
  JsonDocument doc;
  doc["runtimeMode"] = currentRuntimeWifiMode;
  doc["mode"] = activeWifiMode;
  doc["homeSSID"] = homeSSID;
  doc["homePass"] = homePass;
  doc["hotspotSSID"] = hotspotSSID;
  doc["hotspotPass"] = hotspotPass;
  doc["apSSID"] = apSSID;
  doc["apPass"] = apPass;
  doc["currentIP"] = (currentRuntimeWifiMode == 0) ? NetworkPlatform::accessPointIP().toString() : NetworkPlatform::stationIP().toString();
  doc["learnedApIP"] = (learnedApIP.length() > 0) ? learnedApIP : "192.168.0.8";
  doc["defaultApSSID"] = getDefaultApSSID();

  checkDailyBestDateRollover();
  String json;
  serializeJson(doc, json);
  request->send(200, "application/json", json);
}

void handlePostSetWifiConfig(AsyncWebServerRequest *request) {
  String hSsid = request->hasParam("homeSSID") ? request->getParam("homeSSID")->value() : homeSSID;
  String hPass = request->hasParam("homePass") ? request->getParam("homePass")->value() : homePass;
  String hsSsid = request->hasParam("hotspotSSID") ? request->getParam("hotspotSSID")->value() : hotspotSSID;
  String hsPass = request->hasParam("hotspotPass") ? request->getParam("hotspotPass")->value() : hotspotPass;
  String aSsid = request->hasParam("apSSID") ? request->getParam("apSSID")->value() : apSSID;
  String aPass = request->hasParam("apPass") ? request->getParam("apPass")->value() : apPass;
  uint8_t m = request->hasParam("mode") ? request->getParam("mode")->value().toInt() : activeWifiMode;

  saveWifiConfigToFS(m, hSsid, hPass, hsSsid, hsPass, aSsid, aPass);
  request->send(200, "text/plain", "OK");
}

void handlePostSwitchWifi(AsyncWebServerRequest *request) {
  uint8_t mode = 0;
  if (request->hasParam("mode")) {
    mode = request->getParam("mode")->value().toInt();
  }

  if (mode == 2 && hotspotSSID.length() == 0) {
    request->send(400, "text/plain", "Hotspot SSID fehlt!");
    return;
  }

  activeWifiMode = mode;
  saveWifiConfigToFS(activeWifiMode, homeSSID, homePass, hotspotSSID, hotspotPass, apSSID, apPass);

  request->send(200, "text/plain", "Switch initiated");

  triggerWifiSwitch(mode);
}

void handlePostTriggerSzOta(AsyncWebServerRequest *request) {
  if (activeWifiMode == 2) {
    request->send(400, "text/plain", "OTA im Hotspot-Modus gesperrt! Bitte zu Heim-WLAN oder AP-Modus wechseln.");
    return;
  }

  uint8_t broadcastMac[6] = {0xFF, 0xFF, 0xFF, 0xFF, 0xFF, 0xFF};

  HotspotSyncPacket syncPkt;
  syncPkt.magicCode = HOTSPOT_SYNC_MAGIC;

  if (activeWifiMode == 1) {
    strncpy(syncPkt.ssid, homeSSID.c_str(), sizeof(syncPkt.ssid) - 1);
    syncPkt.ssid[sizeof(syncPkt.ssid) - 1] = '\0';
    strncpy(syncPkt.pass, homePass.c_str(), sizeof(syncPkt.pass) - 1);
    syncPkt.pass[sizeof(syncPkt.pass) - 1] = '\0';
  } else {
    String activeApName = (apSSID.length() > 0) ? apSSID : getDefaultApSSID();
    const char* apKey = apPass.length() > 0 ? apPass.c_str() : AP_PASS;
    strncpy(syncPkt.ssid, activeApName.c_str(), sizeof(syncPkt.ssid) - 1);
    syncPkt.ssid[sizeof(syncPkt.ssid) - 1] = '\0';
    strncpy(syncPkt.pass, apKey, sizeof(syncPkt.pass) - 1);
    syncPkt.pass[sizeof(syncPkt.pass) - 1] = '\0';
  }

  for (int i = 0; i < 3; i++) {
    esp_now_send(broadcastMac, (uint8_t *)&syncPkt, sizeof(syncPkt));
    delay(30);
  }
  delay(100);

  uint8_t targetMode = 1; // Immer 1 senden, damit die SZ auch Stufe 2 (feste Notfall-IP 192.168.0.11-13) bei Bedarf ausführt
  sendSZOtaTrigger(targetMode, syncPkt.ssid, syncPkt.pass);

  request->send(200, "text/plain", "SZ OTA Trigger (Legacy & Neu) gesendet");
}


void handlePostBuzzer(AsyncWebServerRequest *request) {
  if (request->hasParam("cmd")) {
    String cmd = request->getParam("cmd")->value();
    if (cmd == "start" || cmd == "start_lights") {
      playBuzzerStartLights();
    } else if (cmd == "lap") {
      playBuzzerLap();
    } else if (cmd == "record") {
      playBuzzerRecord();
    } else if (cmd == "ghost_win" || cmd == "ghost_victory") {
      playBuzzerGhostVictory();
    } else if (cmd == "ghost_ahead") {
      playBuzzerGhostAhead();
    } else if (cmd == "ghost_behind") {
      playBuzzerGhostBehind();
    } else if (cmd == "play" || cmd == "track") {
      String track = request->hasParam("track") ? request->getParam("track")->value() : "";
      bool loop = request->hasParam("loop") ? (request->getParam("loop")->value() == "1" || request->getParam("loop")->value() == "true") : false;
      playBuzzerTrack(track, loop);
    } else if (cmd == "title" || cmd == "gpc" || cmd == "grandprix") {
      playBuzzerTitle();
    } else if (cmd == "menu") {
      playBuzzerMenu();
    } else if (cmd == "stop") {
      stopBuzzer();
    }
  }
  if (request->hasParam("enable")) {
    String en = request->getParam("enable")->value();
    buzzerEnabled = (en == "1" || en == "true");
  }
  request->send(200, "application/json", buzzerEnabled ? "{\"status\":\"ok\",\"enabled\":true}" : "{\"status\":\"ok\",\"enabled\":false}");
}

void handleGetBuzzer(AsyncWebServerRequest *request) {
  String json = "{\"enabled\":" + String(buzzerEnabled ? "true" : "false") +
                ",\"playing\":" + String(isBuzzerActive() ? "true" : "false") +
                ",\"track\":\"" + getBuzzerCurrentTrack() + "\"}";
  request->send(200, "application/json", json);
}

void handlePostCountdown(AsyncWebServerRequest *request) {
  String cmd = request->hasParam("cmd") ? request->getParam("cmd")->value() : "start";
  if (cmd == "cancel" || cmd == "stop") {
    stopBuzzer();
    broadcastWebSocket("{\"type\":\"countdown_cancel\"}");
    request->send(200, "application/json", "{\"status\":\"cancelled\"}");
    return;
  }

  bool muteTts = false;
  if (request->hasParam("muteTts")) {
    String mVal = request->getParam("muteTts")->value();
    muteTts = (mVal == "1" || mVal == "true");
  }

  scheduleBuzzerStartLights(6000);

  char buf[96];
  snprintf(buf, sizeof(buf), "{\"type\":\"countdown\",\"muteTts\":%s}", muteTts ? "true" : "false");
  broadcastWebSocket(buf);

  request->send(200, "application/json", "{\"status\":\"ok\"}");
}
