SirDomsen/RC-LAP-TIMER-PRO/LT_Base/data/lang_en.js

(function() {
  if (window.LT_LANG !== 'en') return;

  const dict = {
    // --- Allgemeine UI & Rollen ---
    "Zurück": "Back",
    "Schließen": "Close",
    "SCHLIESSEN": "CLOSE",
    "ABBRECHEN": "CANCEL",
    "STARTEN": "START",
    "BESTÄTIGEN": "CONFIRM",
    "OK": "OK",
    "Lade...": "Loading...",
    "⏳ Lade...": "⏳ Loading...",
    "Unbekannt": "Unknown",
    "Fahrer": "Driver",
    "Auto": "Car",
    "Fahrzeug": "Car",
    "Fahrzeug unbekannt": "Unknown car",
    "Alle Fahrzeuge": "All cars",
    "Alle Fahrer": "All drivers",
    "Alle Strecken": "All tracks",
    "von": "by",
    "Ziel": "Finish",
    "ZIEL": "FINISH",
    "Platz": "Place",
    "WLAN:": "Wi-Fi:",
    "Speicher:": "Storage:",
    "VOLL! Keine Aufzeichnung!": "FULL! Recording stopped!",
    "Fast voll!": "Almost full!",
    "🛑 Speicher voll ({pct}%)! Sessions werden nicht mehr gespeichert. Bitte erst bestehende Sessions löschen.": "🛑 Storage full ({pct}%)! Sessions are no longer saved. Please delete existing sessions first.",

    // --- Rollen-Badges & Navigation ---
    "🏎️ Aktueller Modus: Fahrer. Zu Rennleiter wechseln 👑": "🏎️ Current mode: Driver. Switch to Race Director 👑",
    "Klicken, um zum Rennleiter-Bereich zu wechseln": "Click to switch to Race Director view",
    "👑 Aktueller Modus: Rennleiter. Zu Fahrer wechseln 🏎️": "👑 Current mode: Race Director. Switch to Driver view 🏎️",
    "Zurück zur Fahrer-Ansicht wechseln": "Switch back to Driver view",
    "Dashboard schließen": "Close dashboard",
    "Top 5 Bestenliste öffnen": "Open Top 5 leaderboard",
    "Klicken für Geister-Einstellungen": "Click for Ghost settings",
    "← Zurück zum Rennleiter": "← Back to Race Director",
    "← Zurück": "← Back",

    // --- Status-Bar & Live-Tabelle ---
    "Modus": "Mode",
    "Restzeit": "Time Left",
    "Führende Runde": "Leading Lap",
    "🏎️ Schnellste Runde": "🏎️ Fastest Lap",
    "Status": "Status",
    "Sektorstationen": "Sector Stations",
    "Sektorstationen:": "Sector Stations:",
    "Website Status": "Website Status",
    "Verbindung zur Basisstation": "Connection to base station",
    "📋 Top 5 ▾": "📋 Top 5 ▾",
    "Klicken für Top 5 Bestenliste": "Click for Top 5 leaderboard",
    "🏆 STRECKENREKORD:": "🏆 TRACK RECORD:",
    "⏱️ TAGESBESTZEIT:": "⏱️ DAILY BEST:",
    "👑 QUALIFYING BEENDET – POLE POSITION 👑": "👑 QUALIFYING FINISHED – POLE POSITION 👑",
    "👑 GEIST GESCHLAGEN – NEUE BESTZEIT! 👑": "👑 GHOST BEATEN – NEW BEST LAP! 👑",
    "DER GEIST (ZIEL) ⚙️": "THE GHOST (TARGET) ⚙️",
    "Klicken, um Geist-Ziel zu wählen / ändern": "Click to select / change ghost target",
    "Strecke:": "Track:",
    "Strecke": "Track",
    "Aktive Strecke:": "Active Track:",
    "Runde": "Lap",
    "Letzte Zeit": "Last Lap",
    "Beste Zeit": "Best Lap",
    "Abstand": "Gap",
    "Pos": "Pos",
    "Fahrer / Auto": "Driver / Car",
    "Warte auf Transponder-Signal...": "Waiting for transponder signal...",
    "Keine Autos erfasst": "No cars detected yet",
    "Tagesbestzeit:": "Daily Best:",
    "Streckenrekord:": "Track Record:",
    "Noch kein Streckenrekord": "No track record yet",
    "Noch keine Bestzeit heute": "No daily best yet",
    "Kein Streckenrekord": "No track record",
    "Keine Bestzeit heute": "No daily best today",
    "QUALI BEENDET": "QUALI FINISHED",
    "LETZTE RUNDE": "FINAL LAP",

    // --- Debug & Update Seiten ---
    "⚠️ TAB MINIMIERT - POLLING & AUFZEICHNUNG PAUSIERT ZUR ESP-ENTLASTUNG": "⚠️ TAB MINIMIZED - POLLING & RECORDING PAUSED TO SAVE ESP RESOURCES",
    "ESP8266 Systemlast": "ESP8266 System Load",
    "Systemlast": "System Load",
    "Metriken abfragen (3s)": "Poll metrics (3s)",
    "Laufzeit": "Uptime",
    "CPU Takt": "CPU Clock",
    "Freier Heap": "Free Heap",
    "Freier PSRAM": "Free PSRAM",
    "Fragmentierung": "Fragmentation",
    "Max. Loop-Dauer": "Max. Loop Time",
    "Debug-Modus ist deaktiviert.": "Debug mode is disabled.",
    "🚀 LITTLEFS DATEI- & SPEICHER-MANAGER": "🚀 LITTLEFS FILE & STORAGE MANAGER",
    "LittleFS Flash-Speicher": "LittleFS Flash Storage",

    // --- Rennmodi ---
    "Freies Training": "Free Practice",
    "FREIES TRAINING": "FREE PRACTICE",
    "TRAINING": "PRACTICE",
    "Qualifying (Beendet)": "Qualifying (Finished)",
    "QUALIFYING (BEENDET)": "QUALIFYING (FINISHED)",
    "Rennen (Runden)": "Race (Laps)",
    "RENNEN (RUNDEN)": "RACE (LAPS)",
    "RENNEN ({cur}/{tot} RND)": "RACE ({cur}/{tot} LAPS)",
    "Rennen (Zeit)": "Race (Time)",
    "RENNEN (ZEIT)": "RACE (TIME)",
    "Freies Training gestartet": "Free practice started",
    "eine Minute": "one minute",
    "Minuten": "minutes",
    "Qualifying gestartet für {dur}!": "Qualifying started for {dur}!",
    "Dragrace gestartet! Zeiterfassung startet bei Überfahrt der Basis.": "Drag race started! Timing begins when crossing the base station.",
    "Durchgang gestoppt. Freies Training.": "Session stopped. Free practice.",

    // --- Buttons in Fahrer & Admin Ansicht ---
    "📱 Dashboard": "📱 Dashboard",
    "📊 Statistiken": "📊 Statistics",
    "🔊 Ton: AN": "🔊 Audio: ON",
    "🔇 Ton: AUS": "🔇 Audio: OFF",
    "Sprachausgabe aktiviert": "Voice output enabled",
    "🔊 Mein Auto ansagen": "🔊 Announce my car",
    "📱 iOS Ton": "📱 iOS Audio",
    "✅ iOS Ton Aktiv": "✅ iOS Audio Active",
    "📱 QR-Code": "📱 QR Code",
    "👻 Ghosthunt": "👻 Ghosthunt",
    "👻 Ghost Battle": "👻 Ghost Battle",
    "⚙️ Einstellungen": "⚙️ Settings",
    "📼 Arcade Audio": "📼 Arcade Audio",
    "🛠️ Web-Update": "🛠️ Web Update",
    "🩺 Diagnose": "🩺 Diagnostics",
    "🏁 Freies Training": "🏁 Free Practice",
    "⏱️ Start Quali": "⏱️ Start Quali",
    "🏎️ Start Runden": "🏎️ Start Laps",
    "⏳ Start Zeit": "⏳ Start Time",
    "🚀 Start Dragrace": "🚀 Start Drag Race",
    "⏹️ Durchgang Stoppen": "⏹️ Stop Session",
    "🔄 Komplett-Reset": "🔄 Full Reset",
    "➕ Neue Strecke": "➕ New Track",
    "💾 Speichern & Schließen": "💾 Save & Close",

    // --- Ghosthunt & Ghost Battle ---
    "Geist": "Ghost",
    "Streckenrekord": "Track Record",
    "Tagesbestzeit": "Daily Best",
    "Persönliche Bestzeit": "Personal Best",
    "Zielzeit": "Target Time",
    "Session-Führender": "Session Leader",
    "Fallback: Eigene PB": "Fallback: Personal Best",
    "mit Sektoren": "with sectors",
    "Start/Ziel": "Start/Finish",
    "Noch kein Streckenrekord (erste Runde setzt Geist)": "No track record yet (first lap sets ghost)",
    "Noch keine Tagesbestzeit": "No daily best yet",
    "Deine Bestzeit:": "Your Best Lap:",
    "Eigener Geist:": "Personal Ghost:",
    "Erste gezeitete Runde dieser Session setzt deinen Geist!": "First timed lap of this session sets your ghost!",
    "Freie Zielzeit:": "Custom Target Time:",
    "Gib unten deine Wunsch-Rundenzeit in Sekunden ein.": "Enter your desired lap time in seconds below.",
    "Session-Führender:": "Session Leader:",
    "Noch keine gezeitete Runde in dieser Session!": "No timed lap in this session yet!",
    "↩️ Admin-Geist übernehmen": "↩️ Use Admin Ghost",
    "⏹️ Ghosthunt beenden": "⏹️ Stop Ghosthunt",
    "👻 Ghosthunt starten": "👻 Start Ghosthunt",
    "🚀 Ghost Battle für alle starten": "🚀 Start Ghost Battle for all",
    "🔄 Geist Aktualisieren": "🔄 Update Ghost",
    "Bitte eine gültige Zielzeit in Sekunden eingeben (z. B. 12.5)!": "Please enter a valid target time in seconds (e.g. 12.5)!",
    "Ghosthunt aktiviert! Schnapp dir den Geist!": "Ghosthunt activated! Catch the ghost!",
    "Ghosthunt gegen den Streckenrekord!": "Ghosthunt against the track record!",
    "Ghosthunt gegen die Tagesbestzeit!": "Ghosthunt against today's best!",
    "Ghosthunt gegen deine persönliche Bestzeit!": "Ghosthunt against your personal best!",
    "Ghosthunt aktiviert! Deine erste Runde setzt den Geist!": "Ghosthunt activated! Your first lap sets the ghost!",
    "Ghosthunt gegen Zielzeit!": "Ghosthunt against target time!",
    "Ghosthunt gegen {driver}!": "Ghosthunt against {driver}!",
    "Noch keine Runden in dieser Session! Erste Runde setzt den Geist.": "No laps in this session yet! First lap sets the ghost.",
    "Zurück zum Session-Geist.": "Back to session ghost.",
    "Ghosthunt beendet.": "Ghosthunt ended.",
    "Ghost Battle gestartet!": "Ghost Battle started!",
    "Ghost Battle beendet.": "Ghost Battle ended.",
    "Geist geschlagen! Neue Bestzeit!": "Ghost beaten! New best lap!",
    "{driver} hat den Geist geschlagen!": "{driver} beat the ghost!",
    "Geist gesetzt: {sec} Sekunden! Schnapp ihn dir!": "Ghost set: {sec} seconds! Go catch it!",

    // --- TTS Ansagen ---
    "Achtung, gleich geht's los!": "Drivers ready, starting soon!",
    "Los!": "Go!",
    "Das Rennen ist beendet!": "The race has finished!",
    "Ziel! Das Rennen ist beendet! Herzlichen Glückwunsch an {driver} auf {car} zum Sieg!": "Finish! The race has ended! Congratulations to {driver} driving {car} on the victory!",
    "Platz 2 geht an {p2}, und Platz 3 an {p3}!": "Second place goes to {p2}, and third place to {p3}!",
    "Platz 2 geht an {p2}!": "Second place goes to {p2}!",
    "Auf den weiteren Plätzen:": "Followed by:",
    "Platz {pos} {driver}.": "Place {pos} {driver}.",
    "{driver} gestartet!": "{driver} started!",
    "{driver}, neue absolute Bestzeit! {time} Sekunden!": "{driver}, new overall best time! {time} seconds!",
    "{driver}, persönliche Bestzeit! {time} Sekunden!": "{driver}, personal best! {time} seconds!",
    "{driver}, Ziel! {time} Sekunden!": "{driver}, finish! {time} seconds!",
    "{driver}, absolute Bestzeit Sektor {sector}!": "{driver}, overall best sector {sector}!",
    "{driver}, Bestzeit Sektor {sector}!": "{driver}, best sector {sector}!",
    "Noch 5 Runden!": "5 laps remaining!",
    "Noch 3 Runden!": "3 laps remaining!",
    "Letzte Runde!": "Final lap!",
    "Neuer Führender! {driver} übernimmt die Spitze!": "New leader! {driver} takes the lead!",
    "{driver}, Outlap beendet!": "{driver}, outlap complete!",
    "du bist der Schnellste!": "you are the fastest!",
    "du hast derzeit die {pos}. schnellste Zeit,": "you currently have the {pos}. fastest time,",
    "schnellste Rennrunde!": "fastest race lap!",
    "schnellste Runde!": "fastest lap!",
    "neuer Streckenrekord!": "new track record!",
    "neue Tagesbestzeit!": "new daily best!",
    "persönliche Bestzeit!": "personal best!",
    "Noch eine Minute!": "One minute remaining!",
    "Noch 30 Sekunden!": "30 seconds remaining!",
    "Noch 10 Sekunden!": "10 seconds remaining!",
    "Die Zeit ist abgelaufen! Letzte Runde!": "Time is up! Final lap!",
    "Qualifying beendet! Herzlichen Glückwunsch {driver} auf {car} zur Pole Position mit {time}!": "Qualifying finished! Congratulations to {driver} driving {car} on pole position with {time}!",
    "Auf Platz 2 folgen {p2} und {p3} auf Platz 3.": "Second place is {p2} and third place is {p3}.",
    "Auf Platz 2 folgt {p2}.": "Second place is {p2}.",
    "Platz {pos} geht an {driver}.": "Place {pos} goes to {driver}.",
    "Das Qualifying ist beendet!": "Qualifying has finished!",
    "Die Zeit ist abgelaufen! Durchgang beendet!": "Time is up! Session finished!",
    "{driver} verlässt die Box": "{driver} leaving the pits",
    "{driver} wieder gestartet": "{driver} restarted",
    "{driver} auf Outlap!": "{driver} on outlap!",
    "{n1} ist aktiver Jäger. {n2} ist Zuhörer.": "{n1} is the active hunter. {n2} is listening.",
    "Sprachausgabe aktiv für {n1} und {n2}": "Voice output active for {n1} and {n2}",
    "Sprachausgabe aktiv für {n1} auf {c1}": "Voice output active for {n1} driving {c1}",
    "Sprachausgabe für alle Fahrzeuge aktiv": "Voice output active for all cars",

    // --- Config & WLAN Modals ---
    "🏠 Heim-WLAN": "🏠 Home Wi-Fi",
    "📱 Hotspot": "📱 Hotspot",
    "📡 AP-Modus": "📡 AP Mode",
    "Heim-WLAN": "Home Wi-Fi",
    "Hotspot": "Hotspot",
    "unbekannt": "unknown",
    "Fallback von": "Fallback from",
    "aktiv": "active",
    "⚠️ SESSION WIRD BEENDET": "⚠️ SESSION WILL END",
    "Aktuelle Session wird beendet und ein neues Freies Training gestartet.": "Current session will end and a new Free Practice will start.",
    "Das laufende Rennen wird beendet!": "The current race will be stopped!",
    "Namen gelten immer für die gesamte Session.": "Names always apply to the entire session.",
    "BEENDEN & NEU STARTEN": "END & RESTART",
    "❌ SPEICHERFEHLER": "❌ SAVE ERROR",
    "Die Änderungen an den Fahrer-/Auto-Zuordnungen konnten nicht vollständig gespeichert werden. Bitte prüfe die Verbindung und kontrolliere die Zuordnungen erneut.": "Changes to driver/car mappings could not be saved completely. Please check your connection and verify the mappings.",
    "⚠️ FEHLENDE EINGABE": "⚠️ MISSING INPUT",
    "Bitte erst eine Hotspot-SSID in den WLAN-Einstellungen eintragen!": "Please enter a Hotspot SSID in the Wi-Fi settings first!",
    "Heimnetzwerk": "HomeNetwork",
    "[IP-Adresse]": "[IP-Address]",
    "<IP aus Geister-WLAN>": "<IP from Helper Wi-Fi>",
    "1. Im Smartphone-WLAN nach Geister-WLAN suchen:": "1. Look for the helper Wi-Fi on your phone:",
    "2. Im Heim-WLAN im Browser öffnen:": "2. Open in browser on your home Wi-Fi:",
    "Der Laptimer verbindet sich mit deinem Heim-WLAN per DHCP. Die vom Router vergebene IP liest du einfach am Ende des Geister-WLAN-Namens ab!": "The Lap Timer connects to your home Wi-Fi via DHCP. Simply read the assigned IP from the end of the helper Wi-Fi name!",
    "💡 <strong>Super praktisch:</strong> Die Box speichert diese Heim-IP automatisch auch für den AP-Modus! Unterwegs an der Rennstrecke öffnest du den Laptimer also unter exakt derselben Adresse.": "💡 <strong>Super handy:</strong> The box saves this home IP for AP mode too! At the track, you open the Lap Timer at the exact same address.",
    "1. Geister-WLAN oder Hotspot-Liste am Handy prüfen:": "1. Check helper Wi-Fi or your phone's hotspot client list:",
    "2. Im Browser aufrufen:": "2. Open in your browser:",
    "Der Laptimer verbindet sich mit deinem Handy-Hotspot. Lies die vergebene IP aus dem Geister-WLAN oder der Hotspot-Übersicht deines Smartphones ab.": "The Lap Timer connects to your phone hotspot. Read the assigned IP from the helper Wi-Fi name or your phone's hotspot client list.",
    "📱 <strong>Tipp:</strong> Sobald dein Handy die Verbindung per Browser aufruft, schaltet sich das Geister-WLAN nach 20 Sekunden stromsparend ab.": "📱 <strong>Tip:</strong> As soon as your phone opens the page, the helper Wi-Fi turns off automatically after 20 seconds.",
    "1. Smartphone direkt mit Laptimer-WLAN verbinden:": "1. Connect your phone directly to the Lap Timer Wi-Fi:",
    "2. Im Browser öffnen (gewohnte Heim-IP):": "2. Open in browser (learned home IP):",
    "Der Laptimer spannt sein eigenes Direkt-WLAN an der Rennstrecke auf (kein Router erforderlich).": "The Lap Timer creates its own direct Wi-Fi at the track (no router needed).",
    "🎯 <strong>Dank IP-Sync:</strong> Dein Handy verbindet sich mit dem Laptimer-WLAN und nutzt dieselbe IP wie daheim ({ip})!": "🎯 <strong>Thanks to IP-Sync:</strong> Your phone connects to the Lap Timer Wi-Fi using the same IP as at home ({ip})!",
    "Sende Trigger-Signal an Sektorstationen...": "Sending trigger signal to sector stations...",
    "⚠️ Fehler:": "⚠️ Error:",
    "✅ Signal erfolgreich gesendet!<br><br><span style='color:var(--text-main);font-size:13px;font-weight:normal;'>Die Stationen blinken nun schnell (3Hz) und verbinden sich mit dem aktuellen Netzwerk.<br>Flash-Vorgang per OTA kann gestartet werden.</span>": "✅ Signal sent!<br><br><span style='color:var(--text-main);font-size:13px;font-weight:normal;'>Stations are now blinking fast (3Hz) and connecting to the current network.<br>You can start OTA flashing now.</span>",
    "❌ Fehler beim Senden:": "❌ Send error:",
    "Passwort verbergen": "Hide password",
    "Passwort anzeigen": "Show password",

    // --- Top 5 & Delete Modals ---
    "🏆 STRECKENREKORD – TOP 5 (ALL-TIME)": "🏆 TRACK RECORD – TOP 5 (ALL-TIME)",
    "Noch kein Streckenrekord auf dieser Strecke": "No track record on this track yet",
    "⏱️ TAGESBESTZEIT – TOP 5 (HEUTE)": "⏱️ DAILY BEST – TOP 5 (TODAY)",
    "Heute noch keine Zeit auf dieser Strecke gefahren": "No lap time recorded on this track today",
    "Pro Fahrer & Fahrzeug wird jeweils die schnellste Zeit geführt.": "Only the fastest lap per driver & car is listed.",
    "Beim Löschen einer Fehlmessung rückt die vorherige Bestzeit des Fahrers automatisch nach.": "Deleting a false reading automatically promotes the driver's previous best time.",
    "⏳ Runde wird gelöscht – bitte Seite nicht neu laden und das Gerät nicht trennen.": "⏳ Deleting lap – please do not reload the page or disconnect power.",
    "Löschen ist während eines laufenden Rennens gesperrt.": "Deleting is locked while a race is running.",
    "Zu wenig freier Speicher im Basisgerät. Bitte später erneut versuchen (z. B. weniger Geräte verbunden). Es wurde nichts verändert.": "Not enough free memory on the base station. Please try again later (e.g. fewer connected clients). Nothing was changed.",
    "Kein Platz im Dateisystem für das sichere Umschreiben der Session (Flash fast voll). Es wurde nichts verändert.": "Not enough filesystem space to safely rewrite the session (flash almost full). Nothing was changed.",
    "Das Basisgerät bearbeitet gerade einen anderen Löschauftrag. Bitte kurz warten und erneut versuchen.": "The base station is currently processing another delete request. Please wait a moment and try again.",
    "Keine Rückmeldung vom Basisgerät. Bitte Zustand prüfen.": "No response from the base station. Please check device status.",
    "Die Runde wurde in der Session-Datei nicht gefunden (evtl. altes Datenformat). Es wurde nichts verändert.": "Lap not found in the session file (possibly legacy format). Nothing was changed.",
    "🔒 GESPERRT": "🔒 LOCKED",
    "⏱️ TAGESBESTZEIT LÖSCHEN": "⏱️ DELETE DAILY BEST",
    "🏆 STRECKENREKORD LÖSCHEN": "🏆 DELETE TRACK RECORD",

    // --- Stats UI ---
    "🏆 All-Time Rekorde": "🏆 All-Time Records",
    "⏱️ Tagesbestzeiten (Heute)": "⏱️ Daily Bests (Today)",
    "Offizielle Strecken-Rekordliste": "Official track record list",
    "📌 Offizielle Rekorde": "📌 Official Records",
    "Aus allen Sessions ermittelt": "Calculated from all sessions",
    "📊 Aus Sessions": "📊 From Sessions",
    "📍 STRECKE:": "📍 TRACK:",
    "🏎️ FAHRZEUG:": "🏎️ CAR:",
    "👤 FAHRER:": "👤 DRIVER:",
    "SORTIERUNG:": "SORT BY:",
    "⚡ Zeit": "⚡ Time",
    "👤 Fahrer": "👤 Driver",
    "🏎️ Fahrzeug": "🏎️ Car",
    "📅 Datum": "📅 Date",
    "Keine Rekorde für die ausgewählten Kriterien auf {track} vorhanden.": "No records found for the selected criteria on {track}.",
    "🔄 Runden": "🔄 Laps",
    "⚡ Bestzeit": "⚡ Best Lap",
    "Direkt zur Session dieser Strecken-Bestzeit springen": "Jump directly to the session of this track best",
    "Gefahrene Runden:": "Completed Laps:",
    "Bestzeit": "Best Lap",
    "Profil öffnen ▶": "Open profile ▶",
    "Keine Fahrerdaten vorhanden.": "No driver data available.",
    "🔄 Index aus Dateisystem neu aufbauen": "🔄 Rebuild index from filesystem",
    "Keine gespeicherten Durchgänge für diese Auswahl im Index vorhanden.": "No saved sessions found in the index for this selection.",
    "Läufe": "Runs",
    "Runden": "Laps",
    "Laufzeiten": "Run Times",
    "Rundenzeiten": "Lap Times",

    // --- Fehlende Buttons, Labels & Modals aus index.html & admin.html ---
    "RC Lap Timer Pro - Rennleiter": "RC Lap Timer Pro - Race Director",
    "Streckenrekord (": "Track Record (",
    "DEINE RUNDE (": "YOUR LAP (",
    "Runde 0": "Lap 0",
    "Fahrer 1": "Driver 1",
    "Fahrer 2": "Driver 2",
    "BOX": "PIT",
    "Keine aktiven Fahrzeuge auf der Strecke": "No active cars on track",
    "🏎️ Keine aktiven Fahrzeuge auf der Strecke": "🏎️ No active cars on track",
    "🎧 FAHRZEUGE FÜR SPRACHANSAGE & DASHBOARD:": "🎧 CARS FOR VOICE OUTPUT & DASHBOARD:",
    "Wähle bis zu 2 Fahrer für Sprachausgabe und Splitscreen-Dashboard.": "Select up to 2 drivers for voice output and splitscreen dashboard.",
    "🎧 Fahrer 1 wählen...": "🎧 Select Driver 1...",
    "➕ Fahrer 2 (optional)...": "➕ Driver 2 (optional)...",
    "🎧 MEIN FAHRZEUG FÜR SPRACHANSAGE:": "🎧 MY CAR FOR VOICE OUTPUT:",
    "Wähle dein Auto – Rundenzeiten & Sektoren werden live vorgelesen": "Select your car – lap times & sectors are announced live",
    "🔊 Alle Fahrzeuge ansagen": "🔊 Announce all cars",
    "Sprachausgabe für:": "Voice output for:",
    "Warte auf Signal...": "Waiting for signal...",
    "🏎️ Dashboard": "🏎️ Dashboard",
    "📲 QR-Code": "📲 QR Code",
    "⬆ Web-Update": "⬆ Web Update",
    "📡 Debug": "📡 Debug",
    "📍 AKTUELLE STRECKE:": "📍 ACTIVE TRACK:",
    "🏆 Top 5": "🏆 Top 5",
    "PRACTICE": "PRACTICE",
    "Min.": "Min.",
    "Start Quali": "Start Quali",
    "Rnd.": "Laps",
    "Start Runden": "Start Laps",
    "Start Zeit": "Start Time",
    "Start Dragrace": "Start Drag Race",
    "⏹ Durchgang Stoppen": "⏹ Stop Session",
    "Komplett-Reset": "Full Reset",
    "LIVE SENSOR DEBUG (LETZTE 5 IDS)": "LIVE SENSOR DEBUG (LAST 5 IDS)",
    "🏆 TOP 5 BESTENLISTE": "🏆 TOP 5 LEADERBOARD",
    "🏆 TOP 5 BESTENLISTE & KORREKTUR": "🏆 TOP 5 LEADERBOARD & EDIT",
    "Lade Top 5...": "Loading Top 5...",
    "📊 Zur Rekord-Statistik": "📊 Go to Record Stats",
    "👻 GHOSTHUNT (GEISTER-AUSWAHL)": "👻 GHOSTHUNT (SELECT GHOST)",
    "👻 GHOST BATTLE (MODUS 5)": "👻 GHOST BATTLE (MODE 5)",
    "Wähle deinen Gegner (Der Geist):": "Choose your opponent (The Ghost):",
    "🏆 Streckenrekord-Geist (All-Time P1)": "🏆 Track Record Ghost (All-Time P1)",
    "⏱️ Tagesbestzeit-Geist (Heutiges P1)": "⏱️ Daily Best Ghost (Today's P1)",
    "👤 Eigener Geist / Session-PB": "👤 Personal Ghost / Session PB",
    "🏎️ Live-Führender der Session": "🏎️ Live Session Leader",
    "🎯 Freie Wunsch-Zielzeit": "🎯 Custom Target Time",
    "Lade Streckenrekord...": "Loading track record...",
    "Zielzeit in Sekunden (z. B. 12.500):": "Target time in seconds (e.g. 12.500):",
    "🚀 Ghost Battle Starten": "🚀 Start Ghost Battle",
    "⚙️ FAHRER-EINSTELLUNGEN": "⚙️ DRIVER SETTINGS",
    "🎙️ Sprachansagen": "🎙️ Voice Announcements",
    "📢 Sektor-Bestzeiten Sprachansage": "📢 Sector Best Voice Announcements",
    "Sagt neue absolute und persönliche Sektor-Bestzeiten an": "Announces new overall and personal best sector times",
    "⏱️ SZ-Durchfahrts-Ticks (SZ1–SZ3 Beep)": "⏱️ Sector Crossing Ticks (SZ1–SZ3 Beep)",
    "A7 Chiptune-Tick: Fahrer 1 einfacher Beep, Fahrer 2 doppelter Beep": "A7 chiptune tick: Driver 1 single beep, Driver 2 double beep",
    "👻 Ghost Sektor-Pieptöne (Buzzer & Beeps)": "👻 Ghost Sector Beeps (Buzzer & Beeps)",
    "Hoher Doppel-Beep bei Vorsprung, Bass-Beep bei Rückstand": "High double-beep when ahead, low bass-beep when behind",
    "🗣️ Ghost Sektor-Sprachausgabe (Delta)": "🗣️ Ghost Sector Voice Delta",
    "Sagt Vorsprung/Rückstand auf Hundertstel an (z. B. „Minus eins fünfundzwanzig“)": "Announces lead/gap to the hundredth (e.g. 'Minus one twenty-five')",
    "📢 Rundenzeiten im Rennen ansagen": "📢 Announce lap times in races",
    "Platzierungen werden im Rennen immer angesagt": "Positions are always announced during races",
    "(Platzierungen werden immer angesagt)": "(Positions are always announced)",
    "🚦 Countdown-Sprachansage stummschalten": "🚦 Mute countdown voice",
    "Kein Sprach-Countdown (3-2-1), sondern nur der synchrone Startampel-Buzzer": "No voice countdown (3-2-1), only the synchronized start light buzzer",
    "(Kein Sprach-Countdown 3-2-1, sondern nur der synchrone Startampel-Buzzer)": "(No voice countdown 3-2-1, only the synchronized start light buzzer)",
    "👑 ZUM RENMLEITER WECHSELN?": "👑 SWITCH TO RACE DIRECTOR?",
    "Im Rennleiter-Bereich können Rennmodi gesteuert, Durchgänge gestartet/gestoppt und Systemeinstellungen geändert werden.": "In the Race Director view you can control race modes, start/stop sessions, and change system settings.",
    "Ja, wirklich zum Rennleiter-Bereich wechseln": "Yes, switch to Race Director view",
    "WEITER ZUM ADMIN 👑": "CONTINUE TO ADMIN 👑",
    "📊 STATISTIKEN & RENN-HISTORIE": "📊 STATISTICS & RACE HISTORY",
    "🌐 Alle Strecken": "🌐 All Tracks",
    "🔄 Index neu aufbauen": "🔄 Rebuild Index",
    "🏆 Rekorde": "🏆 Records",
    "⏱️ Qualifying": "⏱️ Qualifying",
    "🏎️ Rennen (Runden)": "🏎️ Race (Laps)",
    "⏳ Rennen (Zeit)": "⏳ Race (Time)",
    "⚡ Dragrace": "⚡ Drag Race",
    "Alle Statistiken löschen": "Delete all statistics",
    "Fahrer-Profil": "Driver Profile",
    "Lade Fahrer-Statistik...": "Loading driver statistics...",
    "Alle Statistiken dieses Fahrers löschen": "Delete all statistics for this driver",
    "SYSTEM-EINSTELLUNGEN": "SYSTEM SETTINGS",
    "Sektorstationen & Modi": "Sector Stations & Modes",
    "SZ1 verwenden": "Use SZ1",
    "SZ2 verwenden": "Use SZ2",
    "SZ3 verwenden": "Use SZ3",
    "Checkpoint-Modus (Alle aktiven SZ Pflicht)": "Checkpoint Mode (All active sectors required)",
    "📶 WLAN Kontrollzentrum": "📶 Wi-Fi Control Center",
    "Hier Daten für alle Netzwerke pflegen. Ein Klick auf die Buttons zwingt die Basis sofort ins gewählte WLAN.": "Manage credentials for all networks here. Clicking a button switches the base station immediately.",
    "Heim-WLAN SSID:": "Home Wi-Fi SSID:",
    "Passwort:": "Password:",
    "Hotspot SSID:": "Hotspot SSID:",
    "AP SSID (Name):": "AP SSID (Name):",
    "Passwort (AP):": "Password (AP):",
    "🏠 Zu Heim-WLAN": "🏠 To Home Wi-Fi",
    "📱 Zu Hotspot": "📱 To Hotspot",
    "📡 Zu AP-Modus": "📡 To AP Mode",
    "🎙️ Sprachausgabe für dieses Handy": "🎙️ Voice Output for This Phone",
    "Wähle, welche Fahrzeuge auf": "Select which cars should be",
    "diesem Gerät": "this device",
    "angesagt werden sollen": "announced on",
    "Alle anhaken": "Select all",
    "Alle abwählen": "Deselect all",
    "Mindest-Rundenzeit / Deadtime (Sek.):": "Minimum Lap Time / Deadtime (sec):",
    "2-Frame Entprellung aktivieren": "Enable 2-frame debounce",
    "Verhindert Geister-Runden und Fehlauslösungen, indem jedes Transponder-Signal doppelt verifiziert wird. Empfohlen in engen Umgebungen.": "Prevents ghost laps and false triggers by verifying each transponder signal twice. Recommended in tight spaces.",
    "Transponder-IDs zuweisen (Fahrer & Auto)": "Assign Transponder IDs (Driver & Car)",
    "Speichern & Schließen": "Save & Close",
    "⚠️ KOMPLETT-RESET": "⚠️ FULL RESET",
    "Möchtest du wirklich alle aktuellen Runden, Sektorzeiten und den laufenden Durchgang komplett zurücksetzen?": "Do you really want to reset all current laps, sector times, and the active session?",
    "⏱️ Tagesbestzeit (Top 5 heute) ebenfalls zurücksetzen": "⏱️ Also reset today's daily bests (Top 5 today)",
    "(Der ewige Streckenrekord bleibt erhalten)": "(The all-time track record will be preserved)",
    "JETZT ZURÜCKSETZEN": "RESET NOW",
    "🚀 WLAN WIRD GEWECHSELT": "🚀 SWITCHING WI-FI",
    "Das System bricht nun alle aktuellen Verbindungen ab und startet den Wechsel.": "The system will now drop all active connections and start switching.",
    "1. Scanne nach diesem Geister-WLAN:": "1. Scan for this helper Wi-Fi:",
    "2. Öffne im Browser:": "2. Open in browser:",
    "ALLES KLAR, AUSFÜHREN!": "GOT IT, PROCEED!",
    "📍 NEUE STRECKE ANLEGEN": "📍 CREATE NEW TRACK",
    "Gib den Namen der Rennstrecke ein. Für jede Strecke wird ein eigenes Verzeichnis mit 5 Statistik-Kategorien und eigenem Streckenrekord geführt.": "Enter the track name. Each track gets its own folder with 5 stat categories and its own track record.",
    "ANLEGEN & WÄHLEN": "CREATE & SELECT",
    "🛑 SPEICHER VOLL!": "🛑 STORAGE FULL!",
    "Speicher voll! Sessions werden nicht mehr gespeichert. Bitte erst bestehende Sessions löschen.": "Storage full! Sessions are no longer saved. Please delete existing sessions first.",
    "Der Flash-Speicher hat die Obergrenze von 95% erreicht (": "Flash storage has reached the 95% limit (",
    "). Die Live-Zeitmessung funktioniert weiterhin, wird aber nicht mehr im Dateisystem aufgezeichnet.": "). Live timing continues to work, but sessions are no longer written to flash.",
    "📊 SESSIONS VERWALTEN": "📊 MANAGE SESSIONS",
    "VERSTANDEN": "GOT IT",
    "Original Accolade MS-DOS PC-Speaker Chiptunes (1987–1990) direkt über den Hardware-Buzzer des ESP8266 abspielen.": "Play original Accolade MS-DOS PC-speaker chiptunes (1987–1990) directly on the ESP8266 hardware buzzer.",
    "Original Accolade MS-DOS PC-Speaker Chiptunes (1987–1990) direkt über den Hardware-Buzzer des": "Play original Accolade MS-DOS PC-speaker chiptunes (1987–1990) directly on the hardware buzzer of the",
    "abspielen.": "directly.",
    "Soundtrack auswählen:": "Select Soundtrack:",
    "Endlosschleife (Loop)": "Loop continuously",
    "▶ Abspielen": "▶ Play",
    "⏹ Stopp": "⏹ Stop",
    "Status: Bereit": "Status: Ready",
    "Renn-Soundeffekte testen:": "Test Race Sound Effects:",
    "🚦 Startampel": "🚦 Start Lights",
    "⏱️ Runden-Tick": "⏱️ Lap Tick",
    "🏆 Rekord-Fanfare": "🏆 Record Fanfare",
    "📲 MIT ZEITMESSUNG VERBINDEN": "📲 CONNECT TO TIMING",
    "Scanne den QR-Code mit der Handykamera, um die Zeitmessung direkt im Browser zu öffnen:": "Scan the QR code with your phone camera to open live timing directly in your browser:",
    "Direkt-Link:": "Direct Link:",

    // --- Attributes (title & placeholder) ---
    "Öffnet das Renn-Dashboard": "Opens the race dashboard",
    "QR-Code zum Verbinden anzeigen": "Show QR code to connect",
    "QR-Code für Fahrer anzeigen": "Show QR code for drivers",
    "Dateisystem durchsuchen und Sessions-Index reparieren": "Scan filesystem and rebuild sessions index",
    "Top 5 Bestenliste & Verwaltung öffnen": "Open Top 5 leaderboard & management",
    "Klicken für Top 5 Bestenliste & Löschfunktion": "Click for Top 5 leaderboard & delete options",
    "Top 5 Streckenrekorde & Tagesbestzeiten verwalten": "Manage Top 5 track records & daily bests",
    "Aktuelle Strecke samt zugehöriger Sessions löschen": "Delete current track and all its sessions",
    "Accolade PC-Speaker Arcade Audio Jukebox": "Accolade PC-Speaker Arcade Audio Jukebox",
    "WLAN Name": "Wi-Fi Name",
    "Passwort": "Password",
    "z.B. Poco F7": "e.g. Poco F7",
    "z.B. RC-LapTimer": "e.g. RC-LapTimer",
    "z.B. Indoor Teppich, Gartenkurs...": "e.g. Indoor Carpet, Backyard Track...",

    // --- Debug & Update HTML ---
    "⚠️ TAB MINIMIERT - POLLING & AUFZEICHNUNG PAUSIERT ZUR ESP-ENTLASTUNG": "⚠️ TAB MINIMIZED - POLLING & RECORDING PAUSED TO SAVE ESP RESOURCES",
    "Ping (Latenz)": "Ping (Latency)",
    "Letzter Boot / Reset-Grund": "Last Boot / Reset Reason",
    "📋 Reset- & Crash-Log": "📋 Reset & Crash Log",
    "🔍 Frontend & Asset Live-Diagnose": "🔍 Frontend & Asset Live Diagnostics",
    "🚀 Alle Assets jetzt testen": "🚀 Test All Assets Now",
    "Prüft HTTP-Status, GZIP-Kompression, WebSocket-Handshake und parst JavaScript live im Browser auf Syntax- und Encoding-Fehler.": "Checks HTTP status, GZIP compression, WebSocket handshake, and parses JavaScript live in the browser for syntax and encoding errors.",
    "Größe": "Size",
    "Syntax- & Header-Prüfung": "Syntax & Header Check",
    "Nicht getestet": "Not tested",
    "Audio & Buzzer Test-Konsole": "Audio & Buzzer Test Console",
    "Bereit": "Ready",
    "Testet alle akustischen Ausgaben des Systems: Physischer Hardware-Buzzer des ESP8266 (GPIO5), lokale Web Audio Synthesizer-Beeps sowie die Web Speech Synthesizer (TTS) Sprachansagen auf dem Smartphone.": "Tests all audio outputs of the system: physical ESP8266 hardware buzzer (GPIO5), local Web Audio synthesizer beeps, and Web Speech (TTS) voice announcements on your phone.",
    "Testet alle akustischen Ausgaben des Systems: Physischer Hardware-Buzzer des": "Tests all audio outputs of the system: physical hardware buzzer of the",
    "lokale Web Audio Synthesizer-Beeps sowie die Web Speech Synthesizer (TTS) Sprachansagen auf dem Smartphone.": "local Web Audio synthesizer beeps, and Web Speech (TTS) voice announcements on your phone.",
    "1. ESP8266 Hardware-Buzzer (PC-Speaker an GPIO5 / D1)": "1. ESP8266 Hardware Buzzer (PC Speaker on GPIO5 / D1)",
    "Hardware-Buzzer (PC-Speaker an": "Hardware Buzzer (PC Speaker on",
    "Sendet HTTP-Kommandos an": "Sends HTTP commands to",
    "zur direkten Tonausgabe über den Basisstations-Lautsprecher.": "for direct audio output via the base station speaker.",
    "Renn-Soundeffekte (FX):": "Race Sound Effects (FX):",
    "🚦 Startampel (2-1-GO!)": "🚦 Start Lights (2-1-GO!)",
    "🏆 Streckenrekord-Fanfare": "🏆 Track Record Fanfare",
    "👻 Sieg über Geist": "👻 Ghost Victory",
    "🟢 Sektor Grün (Vorsprung)": "🟢 Sector Green (Ahead)",
    "🔴 Sektor Rot (Rückstand)": "🔴 Sector Red (Behind)",
    "⏹️ Ton Stoppen": "⏹️ Stop Audio",
    "▶ Track starten": "▶ Start Track",
    "2. Smartphone Web Audio Synthesizer (Lokal im Browser)": "2. Smartphone Web Audio Synthesizer (Local in Browser)",
    "Wird via Web Audio API (Square-Wave Oszillator) latenzfrei direkt auf dem Handy-Lautsprecher erzeugt.": "Generated with zero latency via Web Audio API (square-wave oscillator) directly on your phone speaker.",
    "⏱️ SZ-Tick F1 (A7 einfach 25ms)": "⏱️ Sector Tick D1 (A7 single 25ms)",
    "⏱️ SZ-Tick F2 (A7 doppelt 25/50/25ms)": "⏱️ Sector Tick D2 (A7 double 25/50/25ms)",
    "🟢 Sektor-Vorsprung (Doppel-Beep)": "🟢 Sector Ahead (Double Beep)",
    "🔴 Sektor-Rückstand (Bass-Beep)": "🔴 Sector Behind (Bass Beep)",
    "👻 Geist geschlagen (Fanfare)": "👻 Ghost Beaten (Fanfare)",
    "⏱️ Runden-Tick (1760 Hz)": "⏱️ Lap Tick (1760 Hz)",
    "🚦 Startampel (Rot-Rot-Grün)": "🚦 Start Lights (Red-Red-Green)",
    "🔓 Audio freischalten (iOS)": "🔓 Unlock Audio (iOS)",
    "3. Smartphone Sprachausgabe (Web Speech API / TTS)": "3. Smartphone Voice Output (Web Speech API / TTS)",
    "Rennleiter-Sprachausgabe im Browser mit phonetischer Optimierung für deutsche Aussprache.": "Race director voice output in the browser.",
    "🚦 Start-Countdown (3-2-1-Los)": "🚦 Start Countdown (3-2-1-Go)",
    "⏱️ Rundenansage": "⏱️ Lap Announcement",
    "🟢 Delta Vorsprung (-0.35s)": "🟢 Delta Ahead (-0.35s)",
    "🔴 Delta Rückstand (+1.12s)": "🔴 Delta Behind (+1.12s)",
    "🔋 Akku-Warnung": "🔋 Battery Warning",
    "🏁 Siegerehrung (Ziel)": "🏁 Podium Ceremony (Finish)",
    "⏹️ TTS Stopp": "⏹️ Stop TTS",
    "ESP-NOW Funkpakete (Lokale Historie)": "ESP-NOW Radio Packets (Local History)",
    "Paket-Aufzeichnung aktivieren": "Enable packet recording",
    "Tabelle einfrieren": "Freeze table",
    "Station:": "Station:",
    "Alle": "All",
    "Basis (Heartbeat)": "Base (Heartbeat)",
    "🗑️ Log leeren": "🗑️ Clear Log",
    "Uhrzeit ESP": "ESP Time",
    "Auto-ID": "Car ID",
    "Nutzdaten": "Payload",
    "📋 ESP8266 Reset- & Crash-Log": "📋 ESP8266 Reset & Crash Log",
    "Reset- & Crash-Log": "Reset & Crash Log",
    "Lade Log...": "Loading log...",
    "🗑️ Crash-Log leeren": "🗑️ Clear Crash Log",
    "Belegt:": "Used:",
    "Frei:": "Free:",
    "Gesamt:": "Total:",
    "Dateien hochladen": "Upload Files",
    "Ziel: 📁 / (Hauptverzeichnis)": "Target: 📁 / (Root)",
    "Ziel:": "Target:",
    "Hauptverzeichnis": "Root",
    "Auf Hauptverzeichnis zurücksetzen": "Reset to root folder",
    "Auto-Gzip aktiv:": "Auto-Gzip active:",
    ") werden direkt im Browser vor dem Senden komprimiert . Das originale PC-Änderungsdatum bleibt exakt erhalten .": ") are compressed right in the browser before upload. Original file timestamps are preserved.",
    "⚡ Dateien automatisch vor dem Upload komprimieren (.gz)": "⚡ Automatically compress files before upload (.gz)",
    "Dateien, Ordner oder .zip-Backup hier ablegen": "Drop files, folders, or .zip backup here",
    "📄 Dateien wählen": "📄 Select Files",
    "📁 Ordner wählen": "📁 Select Folder",
    "📦 Backup (.zip) einspielen": "📦 Restore Backup (.zip)",
    "✕ Leeren": "✕ Clear",
    "Upload starten": "Start Upload",
    "Gespeicherte Dateien im Flash": "Stored Files in Flash",
    "📁 Ordner-Ansicht": "📁 Folder View",
    "📥 Backup (.zip) einspielen": "📥 Restore Backup (.zip)",
    "Aktualisieren 🔄": "Refresh 🔄",
    "Dateiname": "Filename",
    "Geändert am": "Modified",
    "Aktion": "Action",
    "Lade Dateiliste...": "Loading file list...",
    "⚡ Firmware OTA Update (.bin)": "⚡ Firmware OTA Update (.bin)",
    "Hier kann eine kompilierte": "Here you can flash a compiled",
    "direkt über das WLAN geflasht werden.": "directly over Wi-Fi.",
    "Der Fortschritt wird live in Prozent angezeigt. Nach erfolgreichem Flash startet der ESP8266 automatisch neu.": "Progress is shown live in percent. After a successful flash, the ESP8266 reboots automatically.",
    "Der Fortschritt wird live in Prozent angezeigt. Nach erfolgreichem Flash startet der": "Progress is shown live in percent. After a successful flash, the",
    "automatisch neu.": "reboots automatically.",
    "📁 Klicke hier, um eine .bin Firmware-Datei auszuwählen": "📁 Click here to select a .bin firmware file",
    "Firmware jetzt flashen ⚡": "Flash Firmware Now ⚡",
    "⚙️ Sektorstationen Wartung (OTA)": "⚙️ Sector Stations Maintenance (OTA)",
    "Versetzt die Sektorstationen in den Flash-Modus. Sie verbinden sich mit dem aktuellen Netzwerk (Ausnahme: Hotspot-Modus nicht unterstützt).": "Puts sector stations into flash mode. They connect to the current network (except hotspot mode, which is not supported).",
    "⚡ SZ OTA-Wartungsmodus starten": "⚡ Start SZ OTA Maintenance Mode",
    "ESP8266 Wartung": "ESP8266 Maintenance",
    "Wartung": "Maintenance",
    "Nach umfangreichen Dateiuploads empfiehlt sich ein gezielter Neustart, um den Heap-Speicher komplett zu defragmentieren .": "After large file uploads, a targeted reboot is recommended to completely defragment heap memory.",
    "⚡ ESP8266 neu starten (Speicher bereinigen)": "⚡ Reboot ESP8266 (Clean Memory)",
    "neu starten (Speicher bereinigen)": "Reboot (Clean Memory)",
    "⚡ SZ WARTUNGSMODUS (OTA)": "⚡ SZ MAINTENANCE MODE (OTA)",
    "Ziel: ---": "Finish: ---",
    "🏁 Keine aktiven Fahrzeuge auf der Strecke": "🏁 No active cars on track",
    "🌍 Alle Strecken": "🌍 All Tracks",
    "💾 Flash:": "💾 Flash:",
    "🏆 Streckenrekord": "🏆 Track Record",
    "LT_Netzwerk-IP": "LT_Network-IP",
    "DIE.ANGEZEIGTE.IP": "THE.SHOWN.IP",
    "Verlauf aller aufgezeichneten Systemstarts, Reboots und Abstürze im Flash (LittleFS": "History of all recorded boots, reboots, and crashes in flash (LittleFS",
    "RC Lap Timer Pro - Speicher & Web Update": "RC Lap Timer Pro - Storage & Web Update",
    "Webdateien (": "Web files (",
    ") werden direkt im Browser vor dem Senden komprimiert": ") are compressed right in the browser before upload",
    ". Das originale PC-Änderungsdatum bleibt exakt erhalten": ". Original file timestamps are preserved",
    "Wartungsmodus an alle Sektorstationen funken?": "Broadcast maintenance mode to all sector stations?",
    "Die Zeitmessung wird unterbrochen, bis die Stationen neu gestartet wurden!": "Timing will be interrupted until the stations are restarted!",

    // --- Offline-Statistik HTML ---
    "RC Lap Timer Pro – Offline-Statistik 1.0": "RC Lap Timer Pro – Offline Statistics 1.0",
    "Offline-Statistikauswertung": "Offline Statistics",
    "· Daten bleiben auf diesem Gerät": "· Data stays on this device",
    "Lap-Timer (IP/Host):": "Lap Timer (IP/Host):",
    "laptimer.local oder IP": "laptimer.local or IP",
    "Lap-Timer IP-Adresse oder Hostname im WLAN": "Lap Timer IP address or hostname on Wi-Fi",
    "📡 Vom Lap Timer laden": "📡 Load from Lap Timer",
    "🗑️ Lap-Timer leeren": "🗑️ Clear Lap Timer",
    "Erst nach erfolgreicher Übertragung verfügbar": "Available after successful transfer",
    "📂 Laden": "📂 Load",
    "Lädt Lap-Timer-Vollbackup (.zip), statistics.zip oder Statistik-JSON": "Loads full Lap Timer backup (.zip), statistics.zip, or statistics JSON",
    "💾 Speichern": "💾 Save",
    "⛶ Vollbild": "⛶ Fullscreen",
    "Lade eine Statistik-/Backup-Datei oder verbinde dich mit dem Lap Timer im WLAN.": "Load a statistics/backup file or connect to the Lap Timer on Wi-Fi.",
    "Deine Rennstatistik – ganz ohne ESP-Verbindung": "Your race statistics – without needing an ESP connection",
    "Lade ein Lap-Timer-Vollbackup, eine gespeicherte": "Load a full Lap Timer backup, a saved",
    "bzw. ein JSON-Backup oder lies den Lap Timer direkt im WLAN aus. Die Datenbank wächst lokal mit jedem Import.": "or JSON backup, or read directly from the Lap Timer on Wi-Fi. The database grows locally with every import.",
    "📍 STRECKE:": "📍 TRACK:",
    "🌍 Alle Strecken": "🌍 All Tracks",
    "🏆 Streckenrekord:": "🏆 Track Record:",
    "⏱️ Tagesbestzeit:": "⏱️ Daily Best:",
    "Statistikbereiche": "Statistics sections",
    "← Zur Statistik": "← Back to Statistics",
    "Fahrer-Profil": "Driver Profile",
    "Sprache wechseln / Switch language": "Switch language / Sprache wechseln",
    "🏁 Renneinstellungen": "🏁 Race Settings",
    "⚙️ Einstellungen": "⚙️ Settings",
    "🏁 RENNEINSTELLUNGEN": "🏁 RACE SETTINGS",
    "⚙️ EINSTELLUNGEN": "⚙️ SETTINGS",
    "📡 Sektorstationen & Rennlogik": "📡 Sector Stations & Race Logic",
    "⏱️ IR-Erfassung & Entprellung": "⏱️ IR Detection & Debouncing",
    "Verhindert Geister-Runden und Fehlauslösungen, indem jedes Transponder-Signal doppelt verifiziert wird.": "Prevents ghost laps and false triggers by double-verifying every transponder signal.",
    "📢 Renn-Durchsagen & Töne": "📢 Race Announcements & Audio",
    "🏎️ Transponder-IDs zuweisen (Fahrer & Auto)": "🏎️ Assign Transponder IDs (Driver & Car)",
    "💡 Onboard RGB-LED": "💡 Onboard RGB LED",
    "↺ Klassik (Grün/Gelb)": "↺ Classic (Green/Yellow)",
    "🌐 Netzwerk bereit": "🌐 Network ready",
    "⏳ Boot / WLAN-Suche": "⏳ Boot / Wi-Fi search",
    "⚡ IR-Signal erkannt": "⚡ IR signal detected",
    "🏁 Runde gezählt": "🏁 Lap counted",
    "Helligkeit:": "Brightness:",
    "⚡ IR-Blitz testen": "⚡ Test IR flash",
    "🏁 Runde testen": "🏁 Test lap"
  };

  window.LT_I18N = Object.assign(window.LT_I18N || {}, dict);

  window.applyI18nDOM = function() {
    document.documentElement.lang = 'en';
    if (document.title && window.LT_I18N[document.title.trim()]) {
      document.title = window.LT_I18N[document.title.trim()];
    }

    if (document.body) {
      const walker = document.createTreeWalker(document.body, NodeFilter.SHOW_TEXT, {
        acceptNode: function(node) {
          const tag = node.parentElement ? node.parentElement.tagName : '';
          if (tag === 'SCRIPT' || tag === 'STYLE' || tag === 'TEXTAREA') return NodeFilter.FILTER_REJECT;
          return NodeFilter.FILTER_ACCEPT;
        }
      });

      let node;
      while ((node = walker.nextNode())) {
        const raw = node.nodeValue;
        const trimmed = raw.trim();
        if (!trimmed) continue;
        if (window.LT_I18N[trimmed]) {
          const lead = raw.match(/^\s*/)[0];
          const trail = raw.match(/\s*$/)[0];
          node.nodeValue = lead + window.LT_I18N[trimmed] + trail;
        }
      }

      document.querySelectorAll('[title],[placeholder],[alt],[aria-label],input[type="button"],input[type="submit"]').forEach(el => {
        ['title', 'placeholder', 'alt', 'aria-label'].forEach(attr => {
          const val = el.getAttribute(attr);
          if (val && window.LT_I18N[val.trim()]) {
            el.setAttribute(attr, window.LT_I18N[val.trim()]);
          }
        });
        if (el.tagName === 'INPUT' && (el.type === 'button' || el.type === 'submit')) {
          if (el.value && window.LT_I18N[el.value.trim()]) {
            el.value = window.LT_I18N[el.value.trim()];
          }
        }
      });

      const langBtn = document.getElementById('langToggleBtn');
      if (langBtn) langBtn.textContent = '🇩🇪 DE';
      if (typeof updateUploadTargetUI === 'function') updateUploadTargetUI();
    }
  };

  if (document.readyState === 'loading') {
    document.addEventListener('DOMContentLoaded', window.applyI18nDOM);
  } else {
    window.applyI18nDOM();
  }
})();
