SirDomsen/RC-LAP-TIMER-PRO/esp8266_rx/src/platform_runtime.h

#ifndef PLATFORM_RUNTIME_H
#define PLATFORM_RUNTIME_H

#include <Arduino.h>

namespace PlatformRuntime {
void init();
void logSystemMetrics(uint32_t maxLoopUs);
bool isHeapCritical(size_t minimumFreeBytes, uint8_t maximumFragmentation, size_t minimumFreeBlockBytes);
}

#endif
