SirDomsen/RC-LAP-TIMER-PRO/esp8266_rx/src/web_server.h

#ifndef WEB_SERVER_H
#define WEB_SERVER_H

#include "config.h"
#include <ESPAsyncWebServer.h>

extern AsyncWebServer server;
extern AsyncWebSocket ws;
extern uint8_t currentRuntimeWifiMode;

void initNetworkAndServer();
void handleNetworkTasks();
void broadcastWebSocket(const String& msg);
void scheduleESPReset(uint16_t delayMs = 500);
bool isHeapCriticalForFileTransfer();

// Netzwerk-Wechsel auslösen
void triggerWifiSwitch(uint8_t mode);

#endif
