SirDomsen/RC-LAP-TIMER-PRO/(commit log)

2026-10-02 Fix esp8266_rx directory tracking
    [config.h, ir_decoder.cpp, ir_decoder.h, lap_logic.cpp, lap_logic.h, main.cpp, storage.cpp]
2026-10-06 addressing some statistic saving and backup bugs
    [lap_logic.cpp, storage.cpp, storage.h, web_handlers.cpp, web_server.cpp]
2026-10-06 bugs fixed, statistics work now
    [lap_logic.cpp, storage.cpp]
2026-10-11 correcting correct highlighting in driver statistics
2026-10-14 some bugfixing. integrating low voltage alert on SZ, using bc337 and 8K2 / 1K8 voltage divider
2026-10-16 relay logic for SZ improved. bidirectional now
2026-10-19 removed serial stuff. refined relay functio improving SZ flashability
2026-10-19 moved 📢
2026-10-20 wakelock canceled. wakelok page left because looks so cool. hard cach reset button added. placing to be changed
2026-10-21 very good promising stage. just working now on few resets if too many clients are trying to reconnect at the same time
2026-10-21 addet Wifi hostnames. button hard reset moved
2026-10-21 new driver portal
2026-10-22 Bug at landingpage fixed
2026-10-23 driver dashbords reworked
2026-10-23 button webupdate does not open tab anymore
2026-10-25 Reworked Stats. Warning: Current stats become incompatible. Full Little_fs erase recommended!
2026-10-28 sockets rework
2026-10-30 first try on esp32S3
2026-10-30 webserver bugfix (durch esp32port)
2026-10-30 some more bugs (esp32-port) fixed. refined stats, introduced records
2026-10-30 refining relay function
2026-10-30 bugfix in relay mode
2026-11-01 Driver "Ghost Race" integrated
2026-11-01 refined driver ghosthunt
2026-11-01 qr-code to share current IP as a link
2026-11-02 Car-IDs und Autonamen nun getrennt handelbar
2026-11-03 step 3: laplogic und ir entwirrt
2026-11-03 GPIO und LED aus lap_logic enfernt
2026-11-03 step15 status LED
2026-11-03 pin config; config.h + hardware-config.h
2026-11-05 fixing timerace
2026-11-05 Bugfix millis() 32bit überlauf
2026-11-13 Heap und Spitzenlast Einsparungen
2026-11-13 Step 1, releasing Handbrake ESP32
2026-11-14 LED+Frontend Settings
